spacecraft-design-lab-2019/SolarActuators/Reference Design - Energy Harvester Board/EBH-10.png

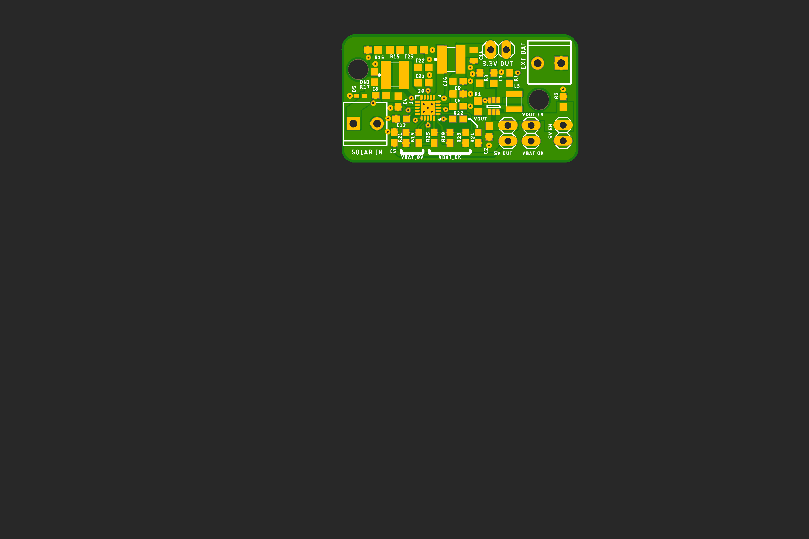
Reference Design - Energy Harvester Board/EBH-10.png
