spacecraft-design-lab-2019/SolarActuators/Reference Design - Energy Harvester Board/OSH EHB-10 2018-04-07/EBH-10.png

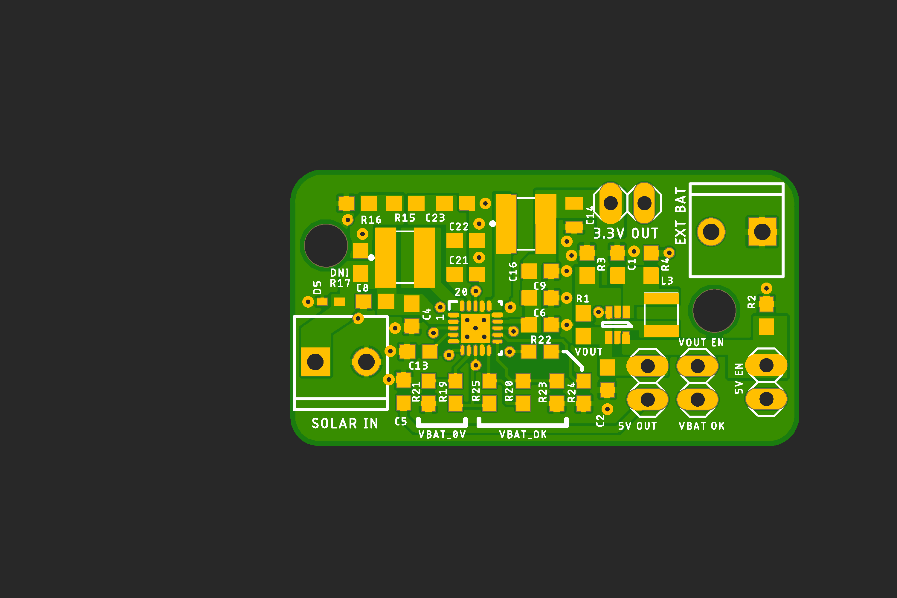
Reference Design - Energy Harvester Board/OSH EHB-10 2018-04-07/EBH-10.png
