spacecraft-design-lab-2019/SolarActuators/Reference Design - Energy Harvester Board/EHB-10_CART_2018-04-10 .xls

CART:4/10/2018 9:01:02 PM
Mouser # | Mfr. # | Manufacturer | Customer # | Description | RoHS | Lifecycle | Order Qty. | Price (USD) | Ext.: (USD)
71-CRCW06037M32FKEA | CRCW06037M32FKEA | Vishay |  | Thick Film Resistors - SMD 1/10watt 7.32Mohms 0.01 | RoHS Compliant By Exemption |  | 100 | $0.026 | $2.60
71-CRCW06038M25FKEA | CRCW06038M25FKEA | Vishay |  | Thick Film Resistors - SMD 1/10watt 8.25Mohms 0.01 | RoHS Compliant By Exemption |  | 100 | $0.026 | $2.60
71-CRCW06035M62FKEA | CRCW06035M62FKEA | Vishay |  | Thick Film Resistors - SMD 1/10watt 5.62Mohms 0.01 | RoHS Compliant By Exemption |  | 100 | $0.026 | $2.60
71-CRCW06034M53FKEA | CRCW06034M53FKEA | Vishay |  | Thick Film Resistors - SMD 1/10watt 4.53Mohms 0.01 | RoHS Compliant By Exemption |  | 100 | $0.026 | $2.60
71-CRCW0603-4.75M-E3 | CRCW06034M75FKEA | Vishay |  | Thick Film Resistors - SMD 1/10watt 4.75Mohms 1% | RoHS Compliant By Exemption |  | 100 | $0.017 | $1.70
652-CR0603FX-3743ELF | CR0603-FX-3743ELF | Bourns |  | Thick Film Resistors - SMD 374K ohm 1% | RoHS Compliant By Exemption |  | 100 | $0.015 | $1.50
71-CRCW0603-110K-E3 | CRCW0603110KFKEA | Vishay |  | Thick Film Resistors - SMD 1/10watt 110Kohms 1% | RoHS Compliant By Exemption |  | 100 | $0.017 | $1.70
71-RCG06031M00FKEA | RCG06031M00FKEA | Vishay |  | Thick Film Resistors - SMD .1watt 1Mohms 1% 0603 100ppm | RoHS Compliant |  | 100 | $0.018 | $1.80
71-CRCW06030000Z0EAC | CRCW06030000Z0EAC | Vishay |  | Thick Film Resistors - SMD 1/10Watt 0ohms Commercial Use | RoHS Compliant By Exemption | New Product | 500 | $0.018 | $9.00
571-4-146278-0 | 4-146278-0 | TE Connectivity |  | Headers & Wire Housings 40 MODII HDR SRST B/A .100CL | No |  | 5 | $1.78 | $8.90
723-BCAP0325P270S17 | BCAP0325 P270 S17 | Maxwell Technologies |  | Supercapacitors / Ultracapacitors 2.7V, 325F, snap-in | RoHS Compliant | New Product | 1 | $15.93 | $15.93
581-SCCV60B107MRB | SCCV60B107MRB | AVX |  | Supercapacitors / Ultracapacitors 2.7V 100F ESR15mOhms 18x60mm Radial Leads | RoHS Compliant | New Product | 3 | $8.08 | $24.24
994-LPS4018-103MRC | LPS4018-103MRC | Coilcraft |  | Fixed Inductors LPS4018 Low Profile 10uH 1.25A 20% SMD | RoHS Compliant |  | 10 | $1.00 | $10.00
994-LPS4018-223MRC | LPS4018-223MRC | Coilcraft |  | Fixed Inductors LPS4018 Low Profile 22uH 0.9A 20% SMD | RoHS Compliant |  | 10 | $1.00 | $10.00
994-EPL3015-472MLB | EPL3015-472MLB | Coilcraft |  | Fixed Inductors EPL3015 AEC-Q200 4.7 uH 20 % 1.4 A | RoHS Compliant |  | 10 | $1.16 | $11.60
621-BZT52C4V7T-7 | BZT52C4V7T-7 | Diodes Incorporated |  | Zener Diodes 300mW 4.7V Zener AEC-Q101 Qualified | RoHS Compliant |  | 10 | $0.181 | $1.81
534-3030 | 3030 | Keystone Electronics |  | Coin Cell Battery Holders 10MM SM COIN CELL CLIP | RoHS Compliant |  | 5 | $0.52 | $2.60
