spacecraft-design-lab-2019/SolarActuators/EnergyHarvesterBoardTest/Vin_smaller than_Vout(EXT BAT)_2019-12-09-15-39-02.857.pdf

Min | Max | Average | Marker X1 | Marker X2
0.009 V | 3.177 V | 3.164V | 3.171 V | 3.177 V
12/9/2019 15:33:30.942 | 12/9/2019 15:30:48.727 | - 12/9/2019 | 15:18:19.925 | 12/9/2019 15:33:16.929
Upper Limit | Lower Limit

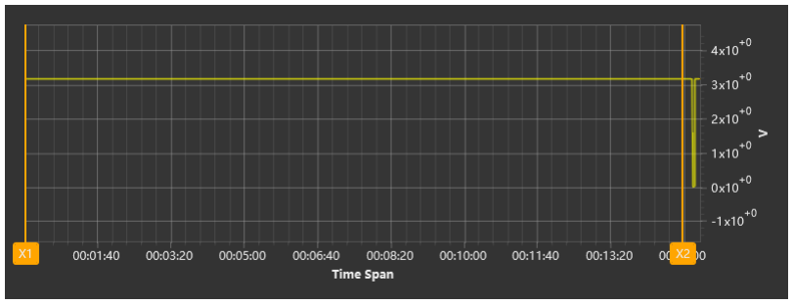
[picture p5: figure]

Trend Chart

Record | Time | Function | Reading | Unit | Limit Test

Device under test

Meter ID

Start Time

Stop time

Elapsed Time

Interval

Total Readings

U1241C MY59350007

12/9/2019 15:18:17.924

12/9/2019 15:33:39.952

00:00:15:22:028

00:00:01:001

922

Logging Session

Record | Time | Function | Reading | Unit | Limit Test
723 | 12/9/2019 15:30:20.698 | Volt {DC} | 3.176 | V
724 | 12/9/2019 15:30:21.699 | Volt {DC} | 3.176 | V
725 | 12/9/2019 15:30:22.700 | Volt {DC} | 3.176 | V
726 | 12/9/2019 15:30:23.701 | Volt {DC} | 3.176 | V
727 | 12/9/2019 15:30:24.702 | Volt {DC} | 3.176 | V
728 | 12/9/2019 15:30:25.704 | Volt {DC} | 3.176 | V
729 | 12/9/2019 15:30:26.705 | Volt {DC} | 3.176 | V
730 | 12/9/2019 15:30:27.706 | Volt {DC} | 3.176 | V
731 | 12/9/2019 15:30:28.707 | Volt {DC} | 3.176 | V
732 | 12/9/2019 15:30:29.709 | Volt {DC} | 3.176 | V
733 | 12/9/2019 15:30:30.709 | Volt {DC} | 3.176 | V
734 | 12/9/2019 15:30:31.710 | Volt {DC} | 3.176 | V
735 | 12/9/2019 15:30:32.711 | Volt {DC} | 3.176 | V
736 | 12/9/2019 15:30:33.712 | Volt {DC} | 3.176 | V
737 | 12/9/2019 15:30:34.713 | Volt {DC} | 3.176 | V
738 | 12/9/2019 15:30:35.715 | Volt {DC} | 3.176 | V
739 | 12/9/2019 15:30:36.716 | Volt {DC} | 3.176 | V
740 | 12/9/2019 15:30:37.717 | Volt {DC} | 3.176 | V

Record | Time | Function | Reading | Unit | Limit Test
741 | 12/9/2019 15:30:38.718 | Volt {DC} | 3.176 | V
742 | 12/9/2019 15:30:39.720 | Volt {DC} | 3.176 | V
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
919 | 12/9/2019 15:33:36.948 | Volt {DC} | 3.177 | V
920 | 12/9/2019 15:33:37.949 | Volt {DC} | 3.177 | V

Remark

Record | Time | Function | Reading | Unit | Limit Test
921 | 12/9/2019 15:33:38.951 | Volt {DC} | 3.177 | V
922 | 12/9/2019 15:33:39.952 | Volt {DC} | 3.177 | V
