spacecraft-design-lab-2019/SolarActuators/EnergyHarvesterBoardTest/Charging Voltage plot_2019-12-09-11-46-00.449.pdf

Min | Max | Average | Marker X1 | Marker X2
3.668 V | 3.979 V | 3.700V
12/9/2019 11:33:59.491 | 12/9/2019 11:33:54.485 | -

Trend Chart

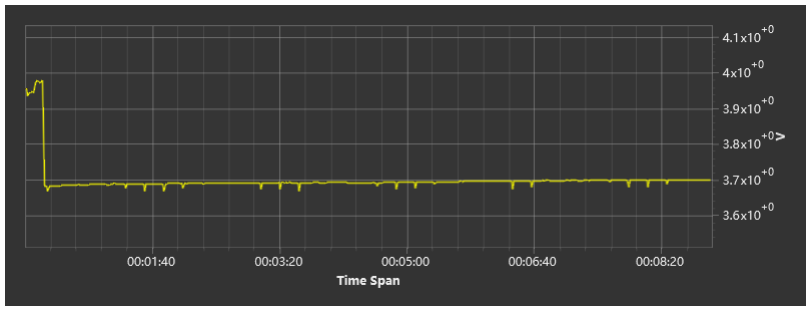
[picture p6: figure]

Record | Time | Function | Reading | Unit
340 | 12/9/2019 11:39:20.881 | Volt {DC} | 3.695 | V
341 | 12/9/2019 11:39:21.882 | Volt {DC} | 3.695 | V
342 | 12/9/2019 11:39:22.883 | Volt {DC} | 3.696 | V

Device under test

Meter ID

Start Time

Stop time

Elapsed Time

Interval

Total Readings

U1241C MY59350007

12/9/2019 11:33:41.469

12/9/2019 11:42:40.097

00:00:08:58:628

00:00:01:001

539

Logging Session

Record | Time | Function | Reading | Unit
343 | 12/9/2019 11:39:23.884 | Volt {DC} | 3.696 | V
344 | 12/9/2019 11:39:24.885 | Volt {DC} | 3.695 | V
345 | 12/9/2019 11:39:25.888 | Volt {DC} | 3.696 | V
346 | 12/9/2019 11:39:26.888 | Volt {DC} | 3.697 | V
347 | 12/9/2019 11:39:27.889 | Volt {DC} | 3.696 | V
348 | 12/9/2019 11:39:28.891 | Volt {DC} | 3.696 | V
349 | 12/9/2019 11:39:29.892 | Volt {DC} | 3.696 | V
350 | 12/9/2019 11:39:30.893 | Volt {DC} | 3.696 | V
351 | 12/9/2019 11:39:31.894 | Volt {DC} | 3.696 | V
352 | 12/9/2019 11:39:32.895 | Volt {DC} | 3.696 | V
353 | 12/9/2019 11:39:33.896 | Volt {DC} | 3.696 | V
354 | 12/9/2019 11:39:34.897 | Volt {DC} | 3.696 | V
355 | 12/9/2019 11:39:35.898 | Volt {DC} | 3.697 | V
356 | 12/9/2019 11:39:36.899 | Volt {DC} | 3.697 | V
357 | 12/9/2019 11:39:37.900 | Volt {DC} | 3.697 | V
358 | 12/9/2019 11:39:38.900 | Volt {DC} | 3.697 | V
359 | 12/9/2019 11:39:39.901 | Volt {DC} | 3.697 | V
360 | 12/9/2019 11:39:40.903 | Volt {DC} | 3.697 | V

Record | Time | Function | Reading | Unit
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
535 | 12/9/2019 11:42:36.094 | Volt {DC} | 3.700 | V
536 | 12/9/2019 11:42:37.095 | Volt {DC} | 3.700 | V
537 | 12/9/2019 11:42:38.096 | Volt {DC} | 3.700 | V
538 | 12/9/2019 11:42:39.097 | Volt {DC} | 3.700 | V
539 | 12/9/2019 11:42:40.097 | Volt {DC} | 3.700 | V

Remark
