spacecraft-design-lab-2019/SolarActuators/EnergyHarvesterBoardTest/Charging Voltage plot.PNG

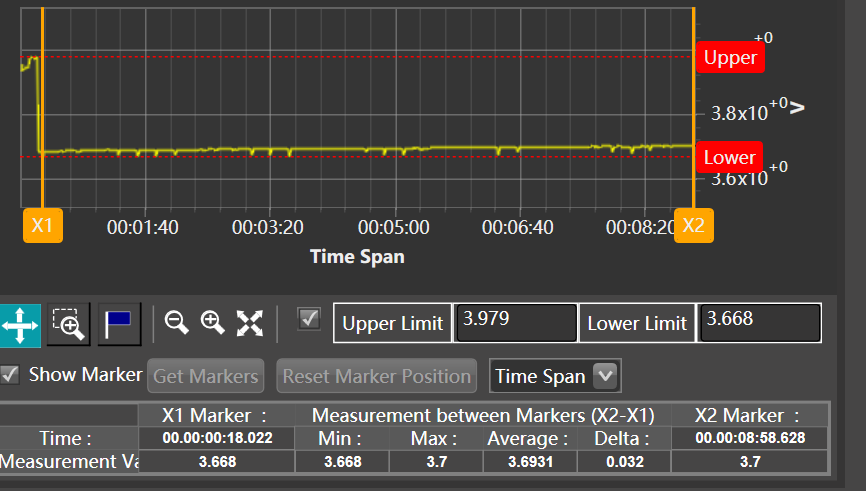
EnergyHarvesterBoardTest/Charging Voltage plot.PNG
