spacecraft-design-lab-2019/SolarActuators/(threads)

Thread 5 (2019-10-16):

Evaluate energy harvesting board (BQ25570RGRR)

maholli, 2019-10-16:

maholli, 2019-10-17:
Same as https://github.com/spacecraft-design-lab-2019/documentation/issues/68

Closed 2019-10-17.
