spacecraft-design-lab-2019/SolarActuators/EnergyHarvesterBoardTest/Energy harvesting board testing 1112.pdf

# Energy harvesting board testing 1112

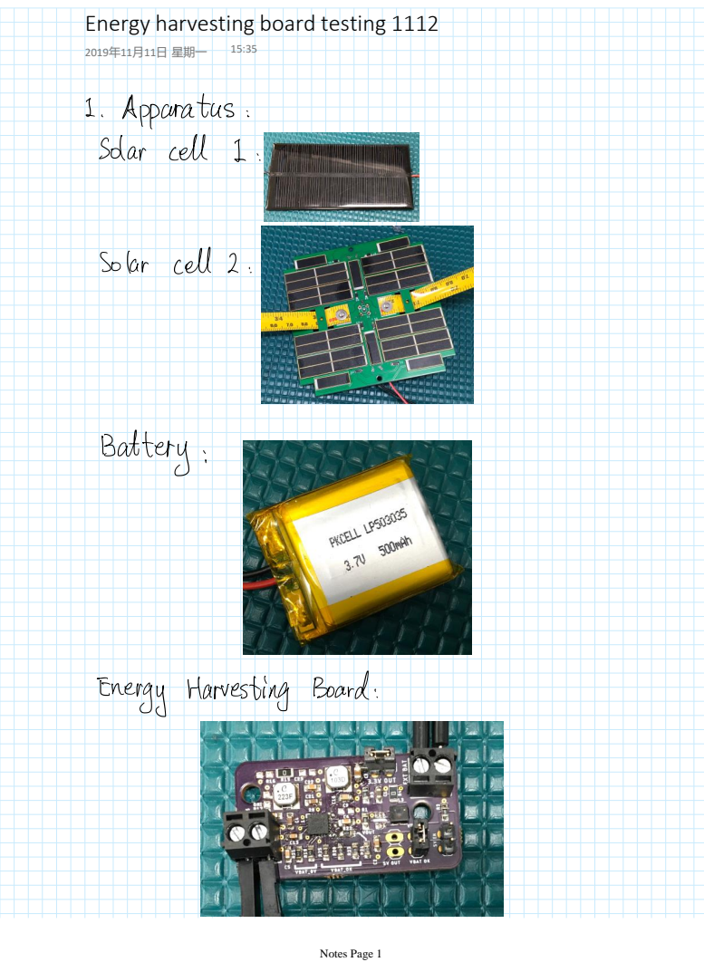
[picture p8: page 1]
星期一; Notes Page 1

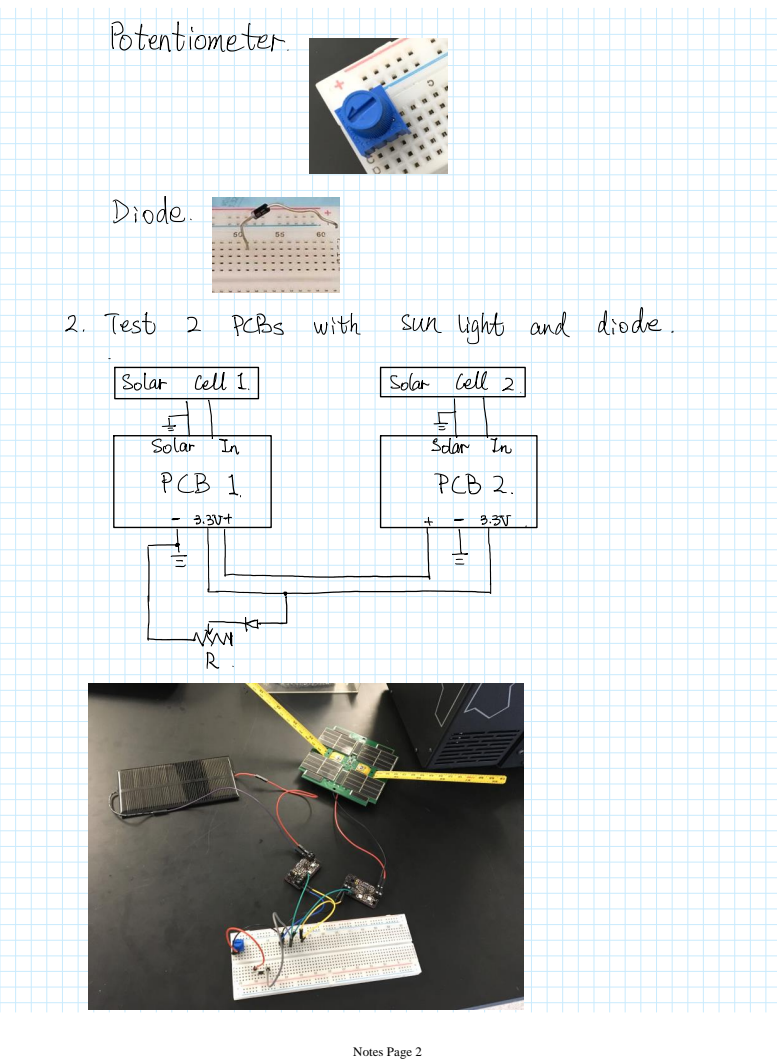
[picture p9: page 2]

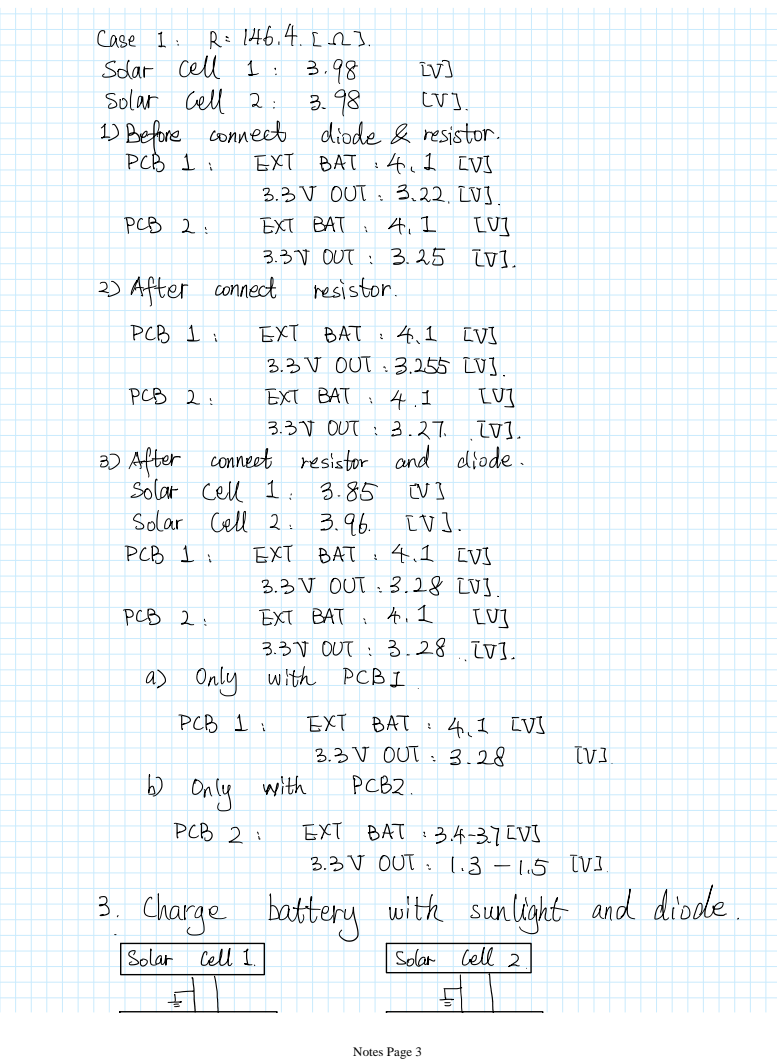
[picture p10: page 3]

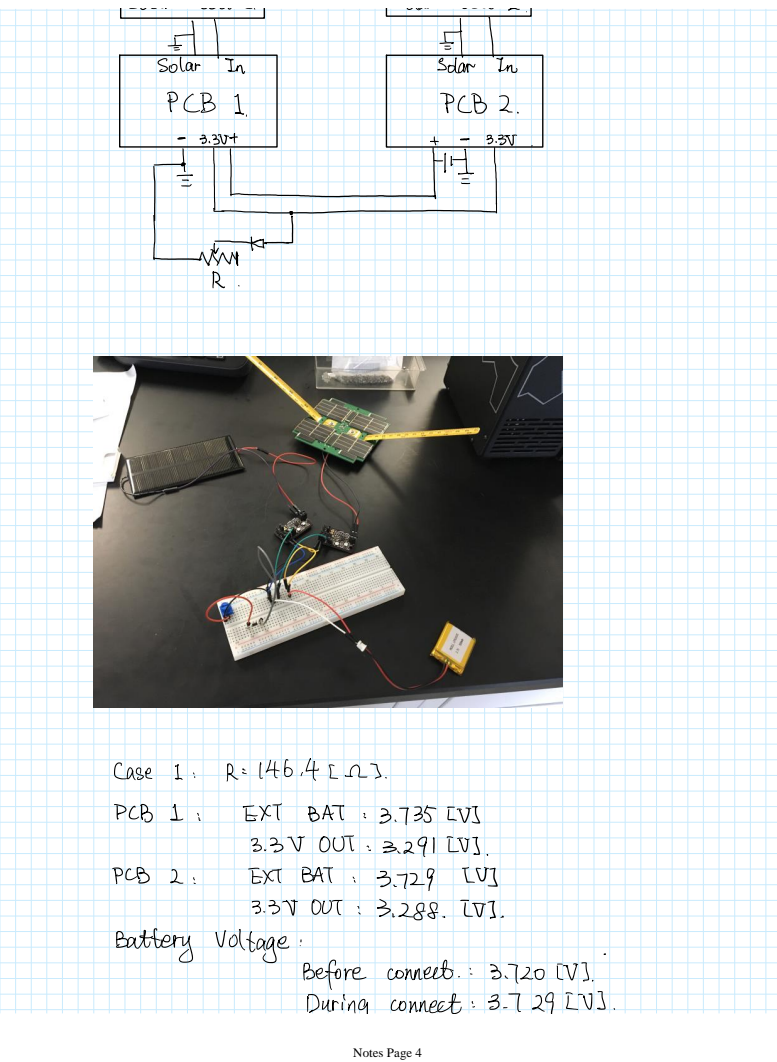
[picture p11: page 4]

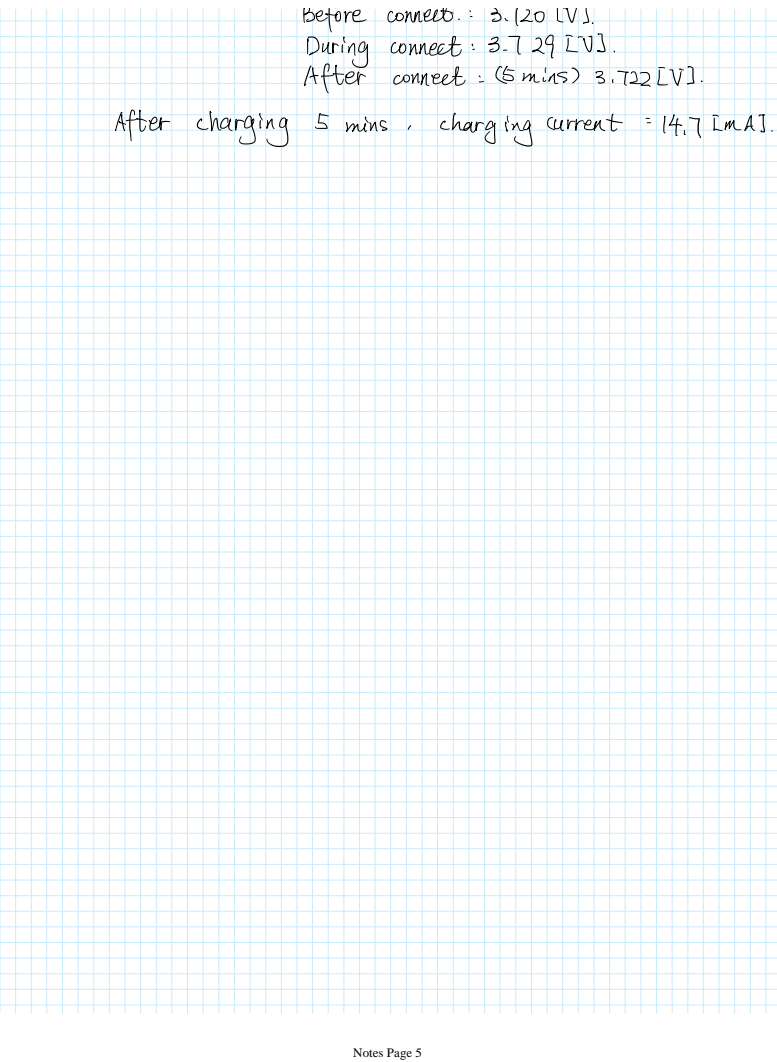
[picture p12: page 5]
