spacecraft-design-lab-2019/SolarActuators/EnergyHarvesterBoardTest/Energy_harvesting_board_testing_1111.pdf

# Energy harvesting board testing 1111

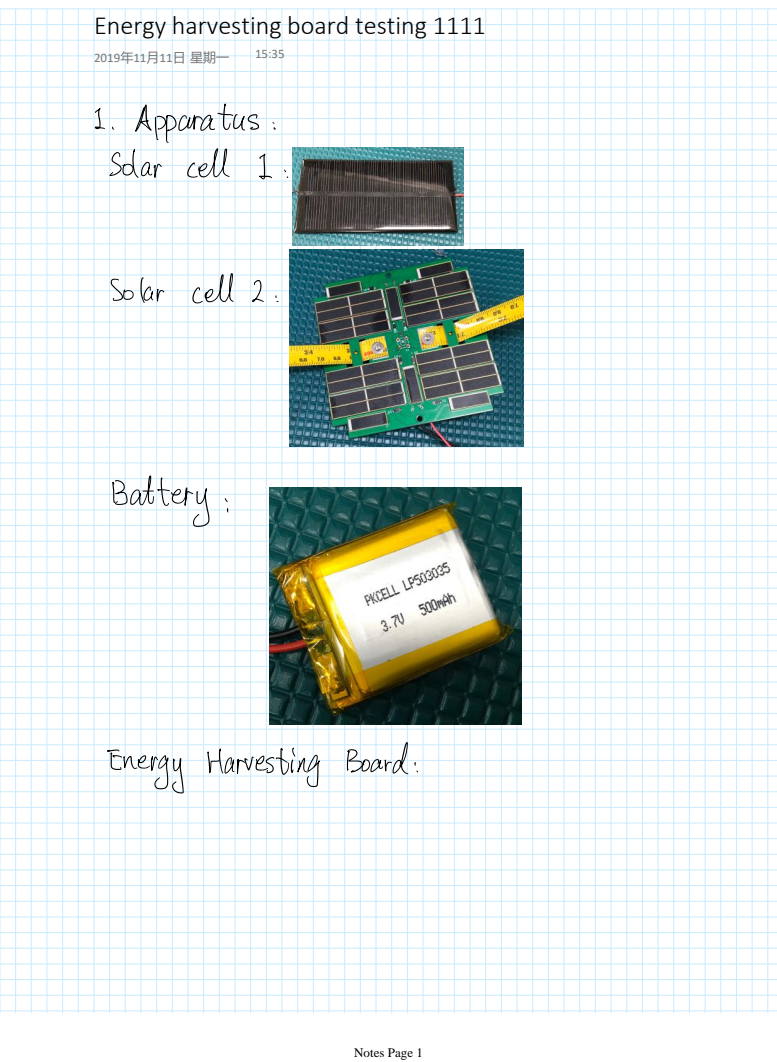
[picture p13: page 1]
星期一; Notes Page 1

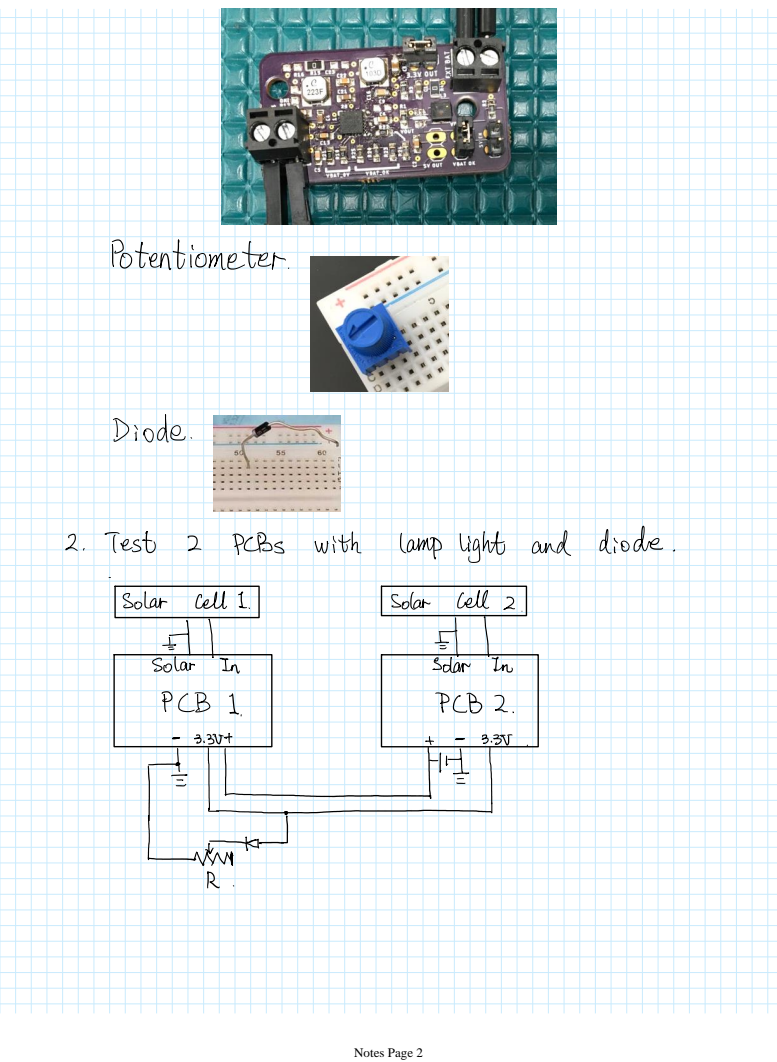
[picture p14: page 2]

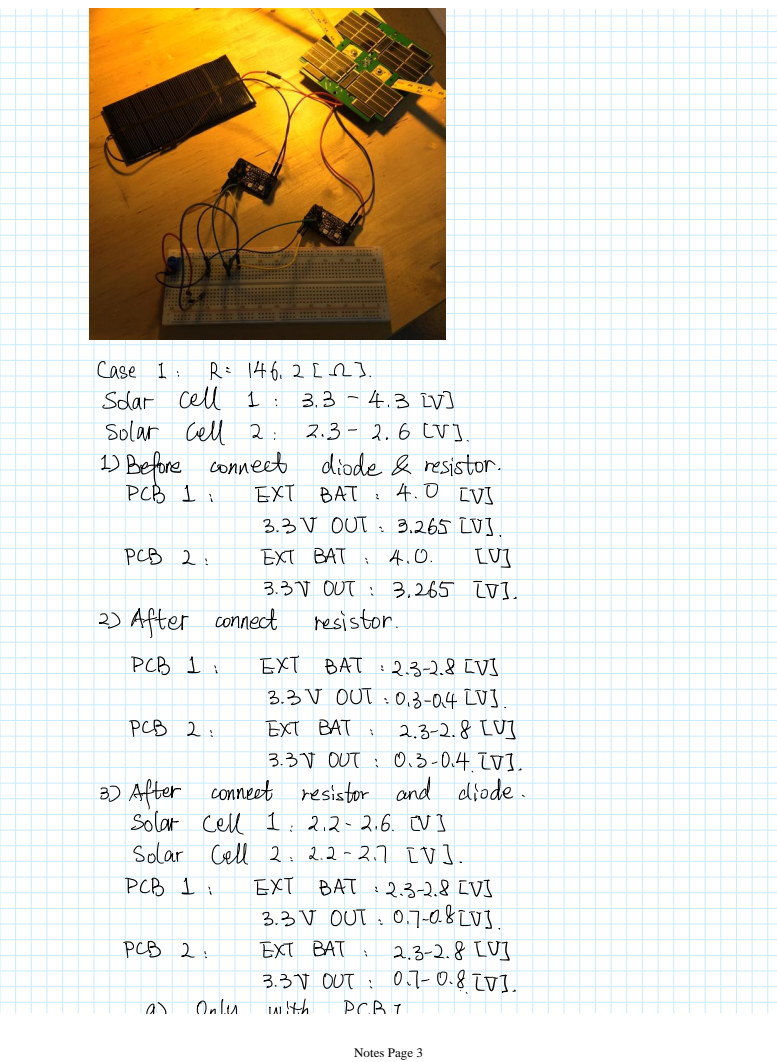
[picture p15: page 3]

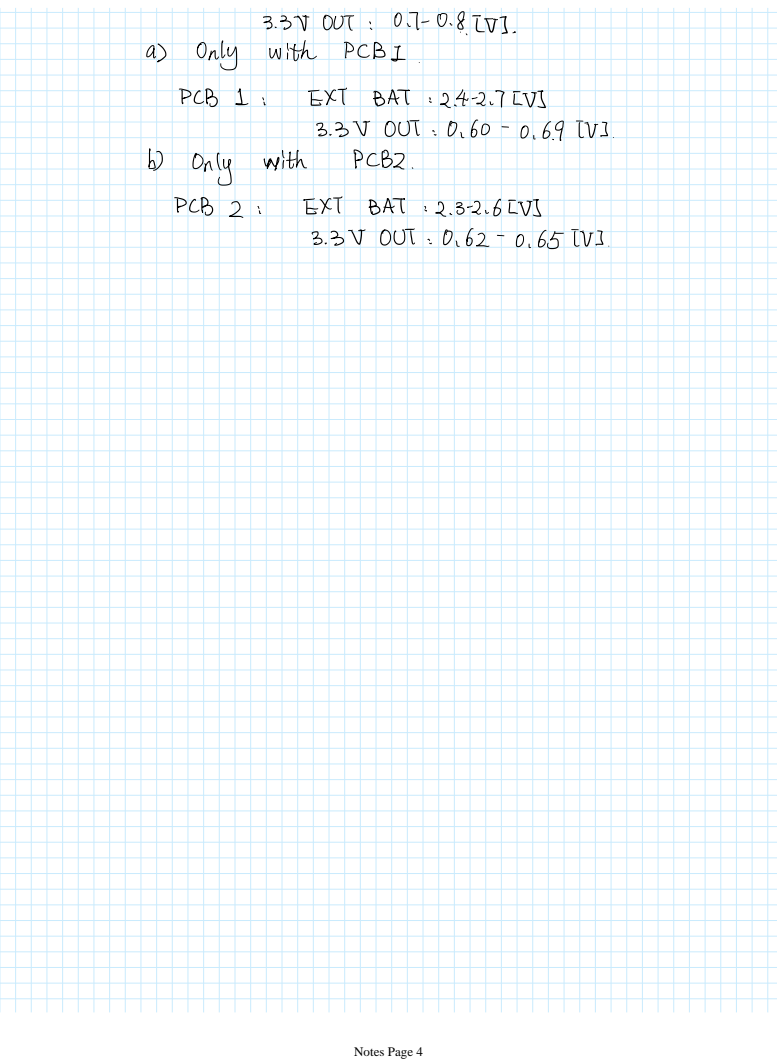
[picture p16: page 4]
