spacecraft-design-lab-2019/SolarActuators/EnergyHarvesterBoardTest/Energy harvesting board testing 1105.pdf

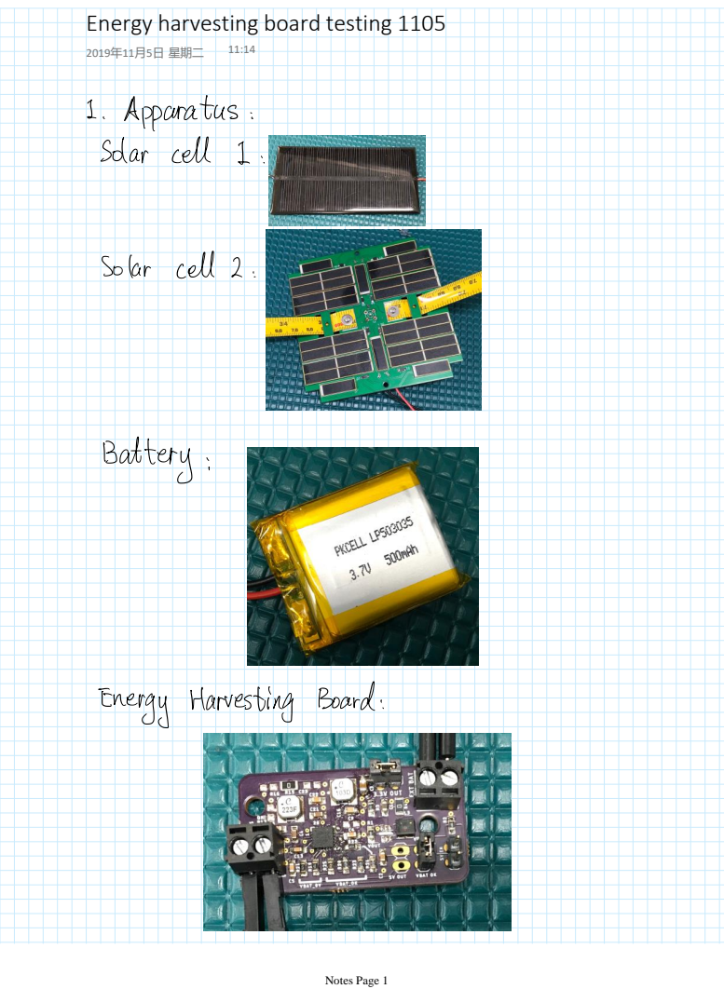
[picture p17: page 1]
2019年11月5日 星期二; Notes Page 1

Energy harvesting board testing 1105

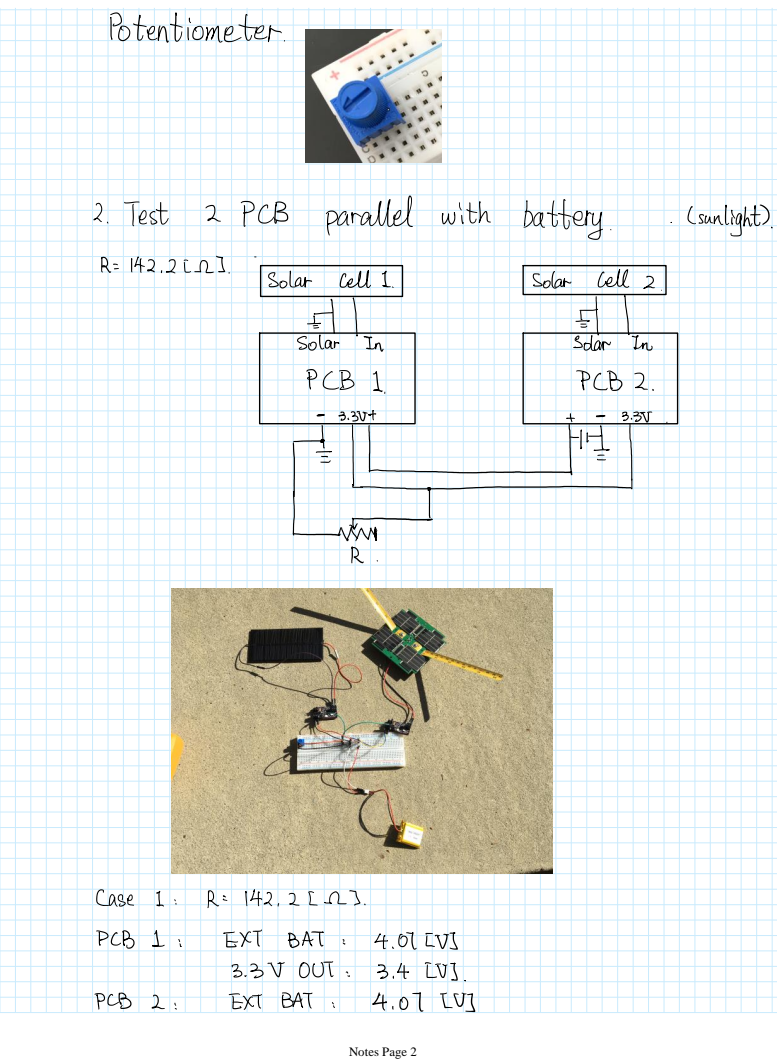
[picture p18: page 2]

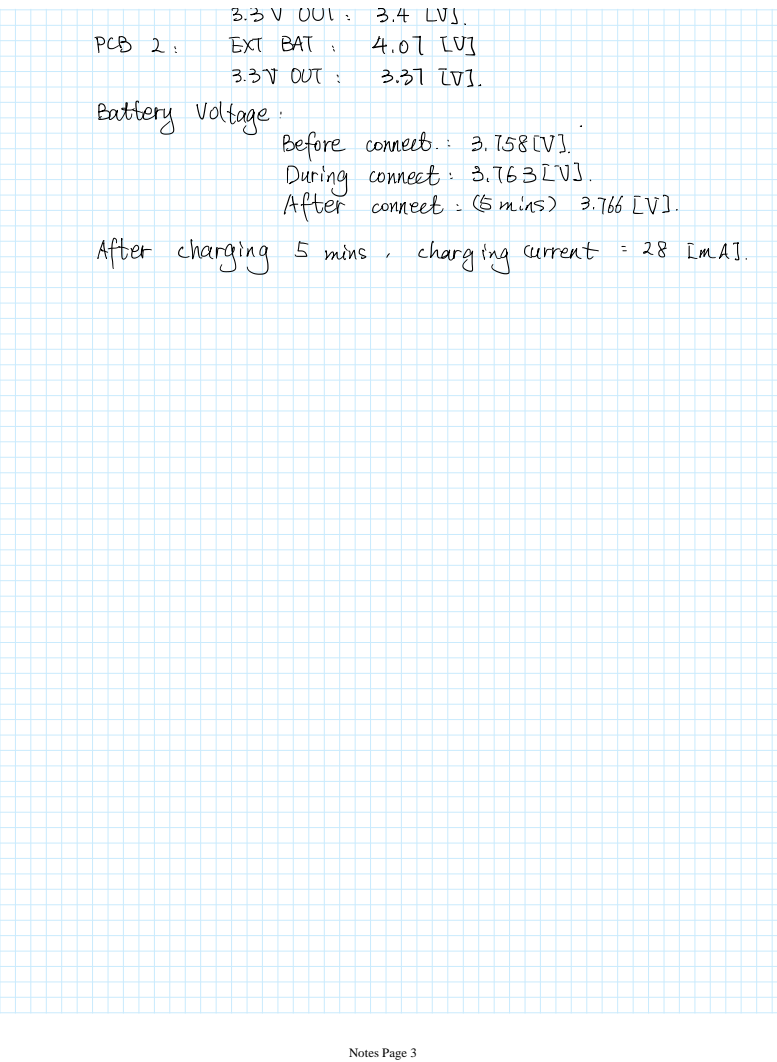
[picture p19: page 3]
