spacecraft-design-lab-2019/SolarActuators/EnergyHarvesterBoardTest/Energy_harvesting_board_testing_1029.pdf

# Energy harvesting board testing 1029

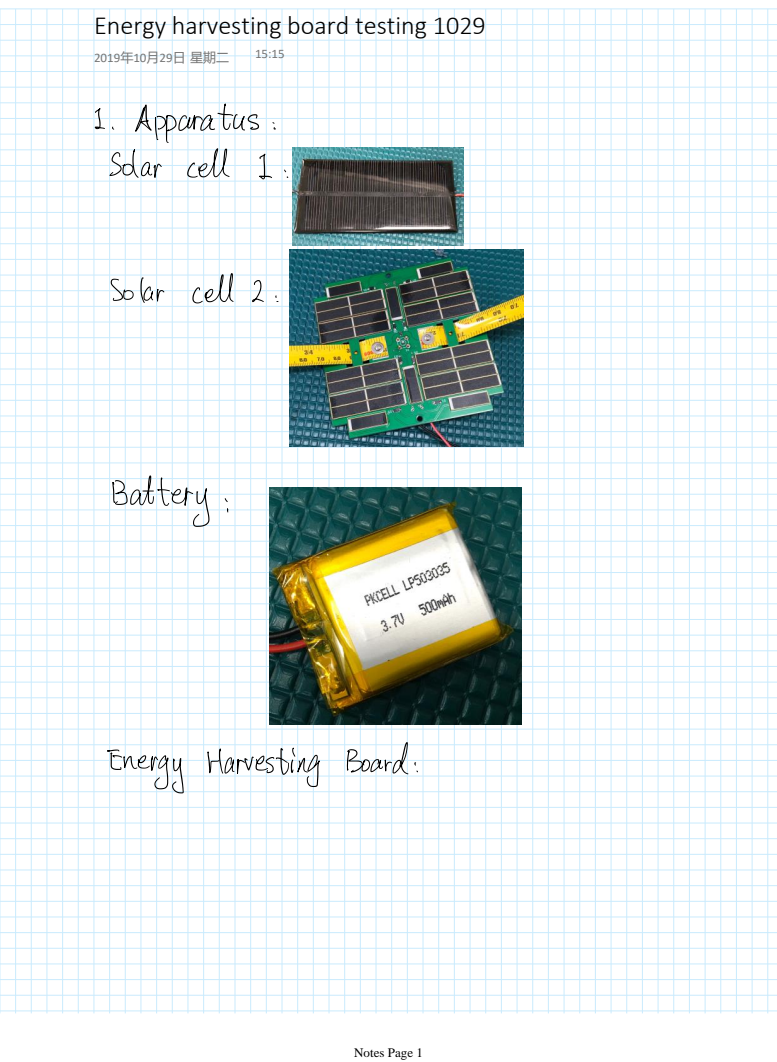
[picture p20: page 1]
星期二; Notes Page 1

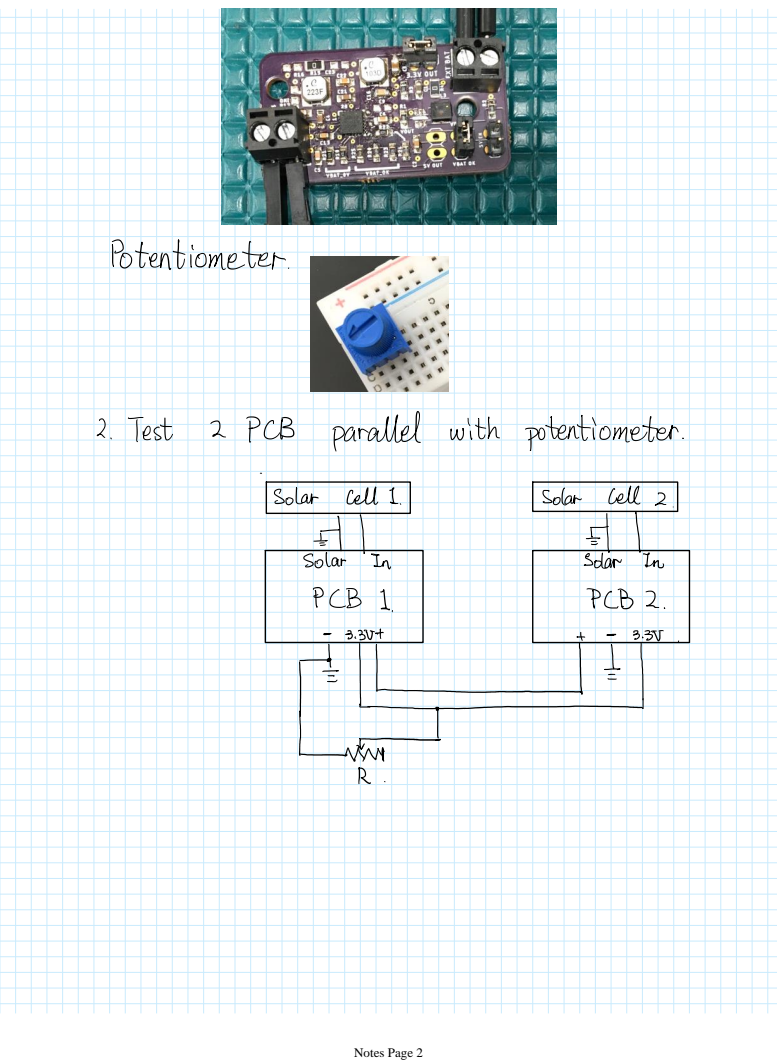
[picture p21: page 2]

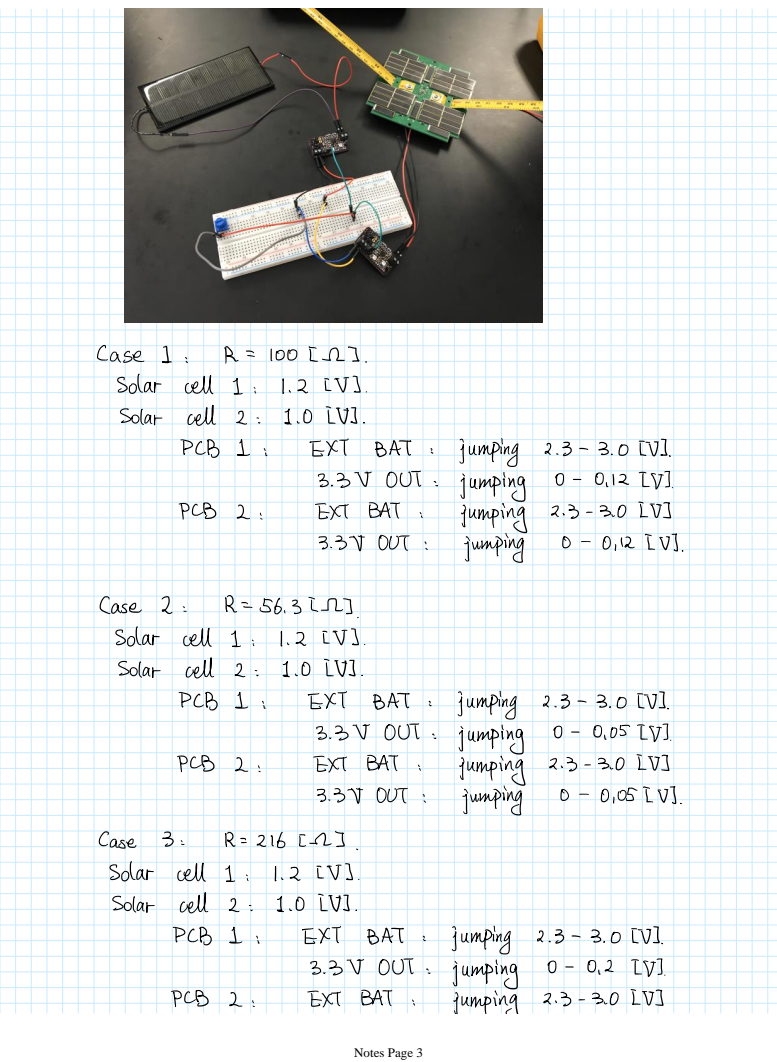
[picture p22: page 3]

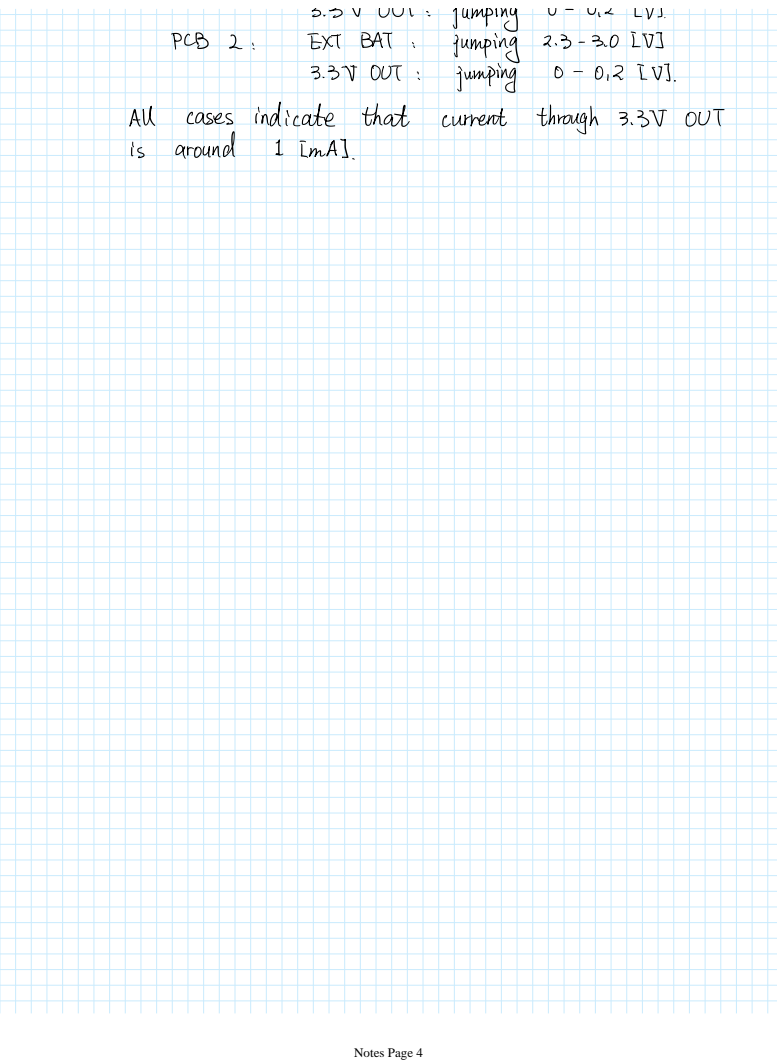
[picture p23: page 4]
