spacecraft-design-lab-2019/SolarActuators/EnergyHarvesterBoardTest/Energy_harvesting_board_testing_1030.pdf

# Energy harvesting board testing 1030

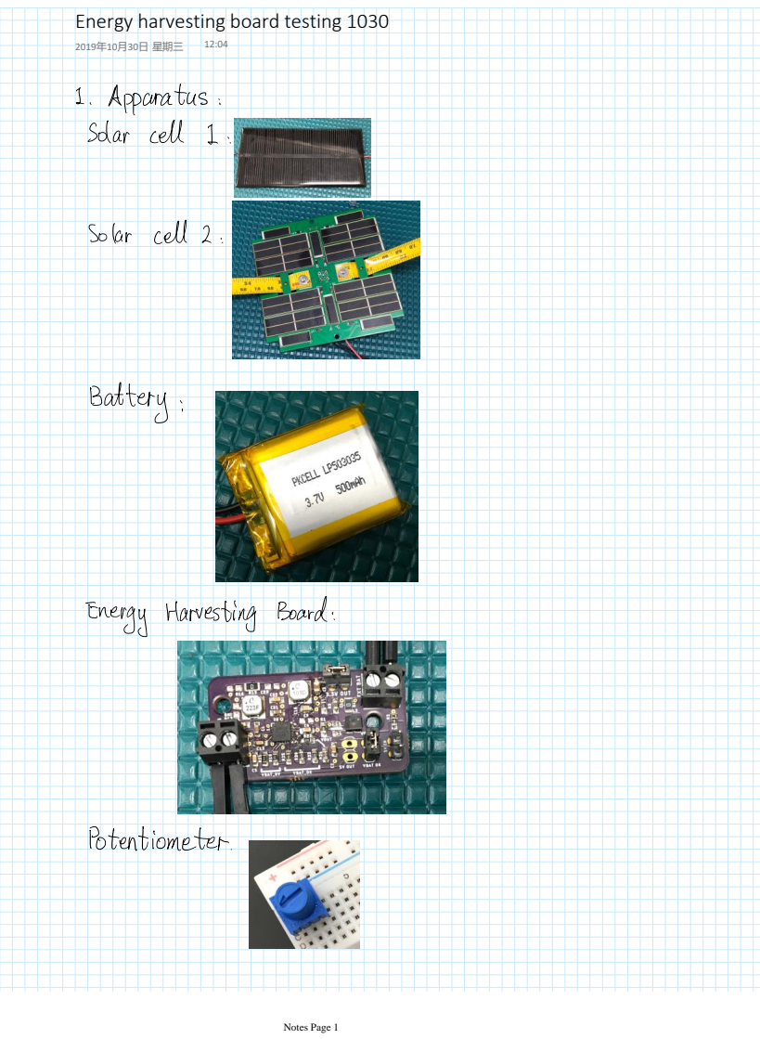
[picture p24: page 1]
星期三; Notes Page 1

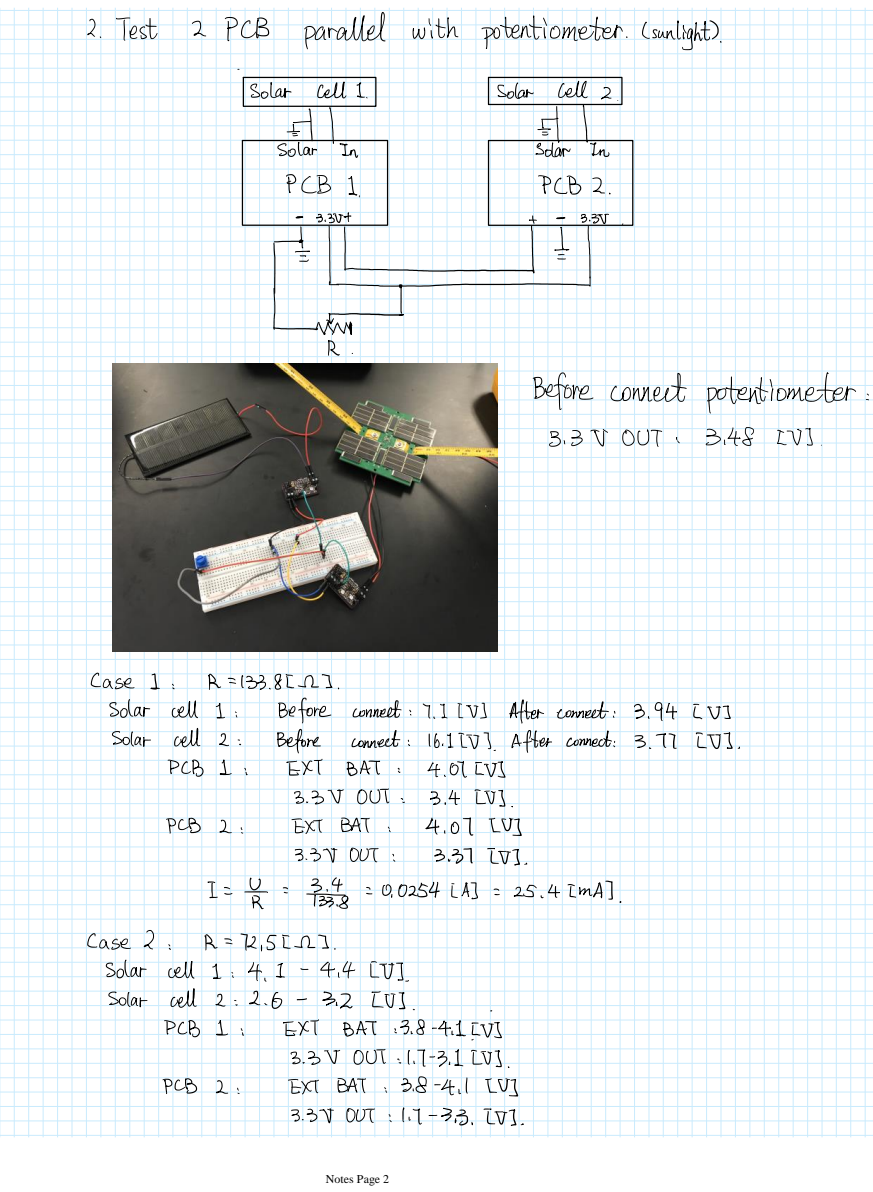
[picture p25: page 2]

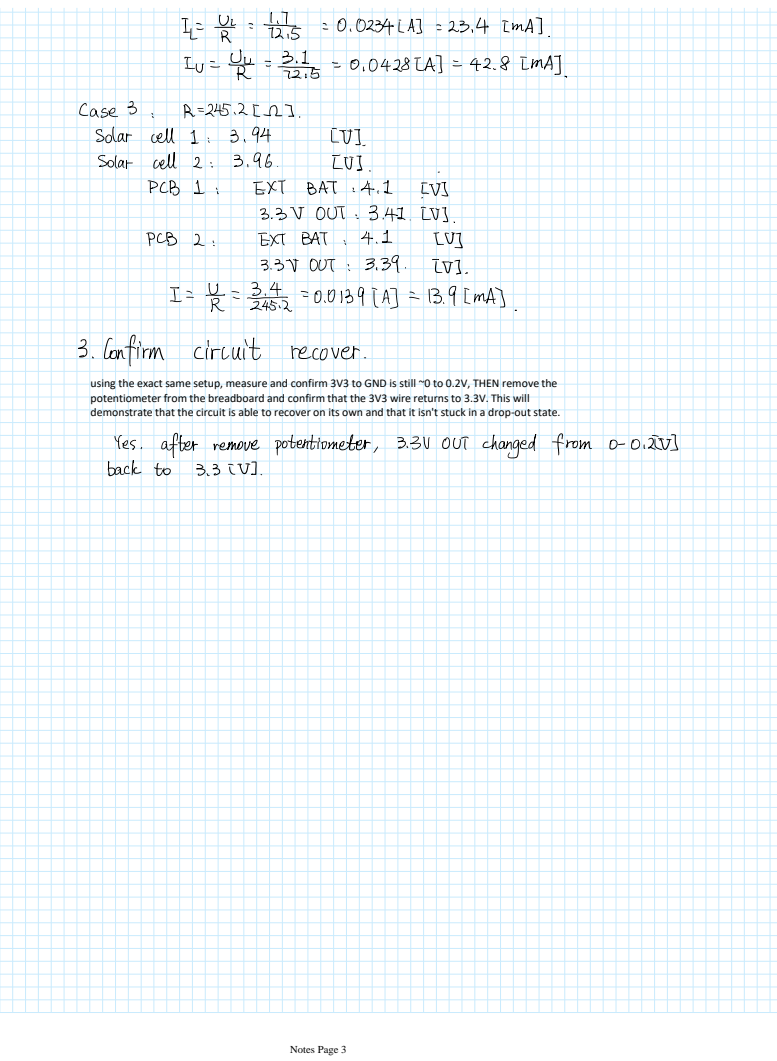
[picture p26: page 3]

using the exact same setup, measure and confirm 3V3 to GND is still ~0 to 0.2V, THEN remove the
potentiometer from the breadboard and confirm that the 3V3 wire returns to 3.3V. This will
demonstrate that the circuit is able to recover on its own and that it isn't stuck in a drop-out state.
