spacecraft-design-lab-2019/SolarActuators/EnergyHarvesterBoardTest/Energy_harvesting_board_testing_1026.pdf

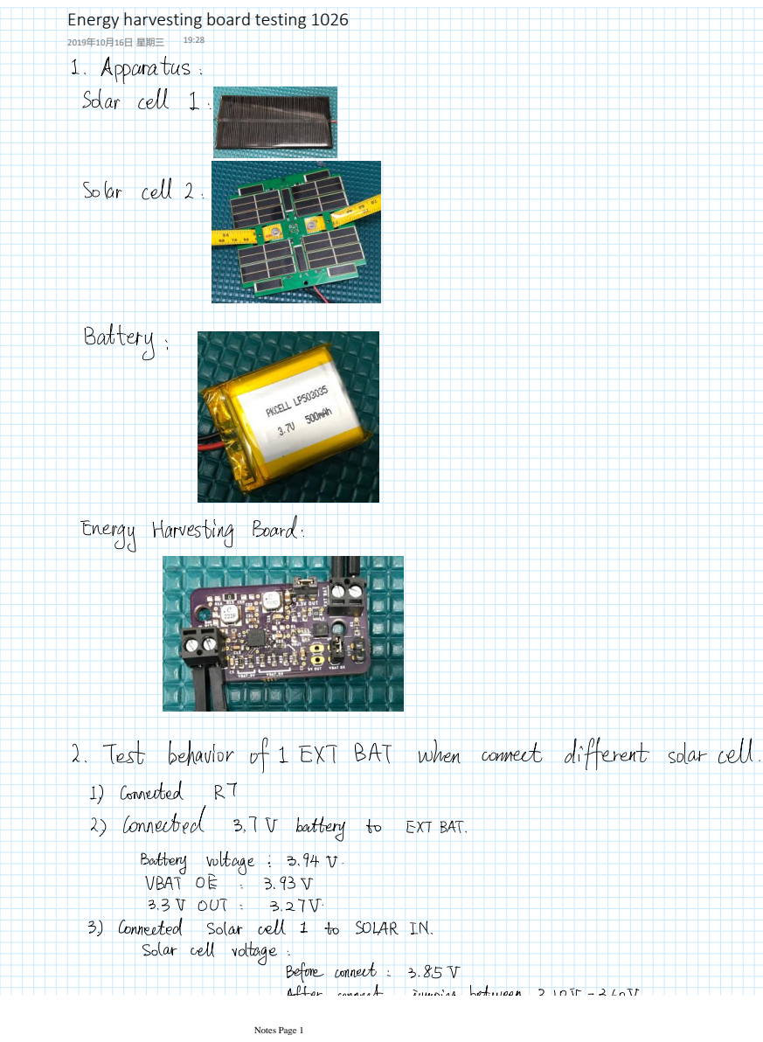
[picture p27: page 1]
星期三; Notes Page 1

Energy harvesting board testing 1026

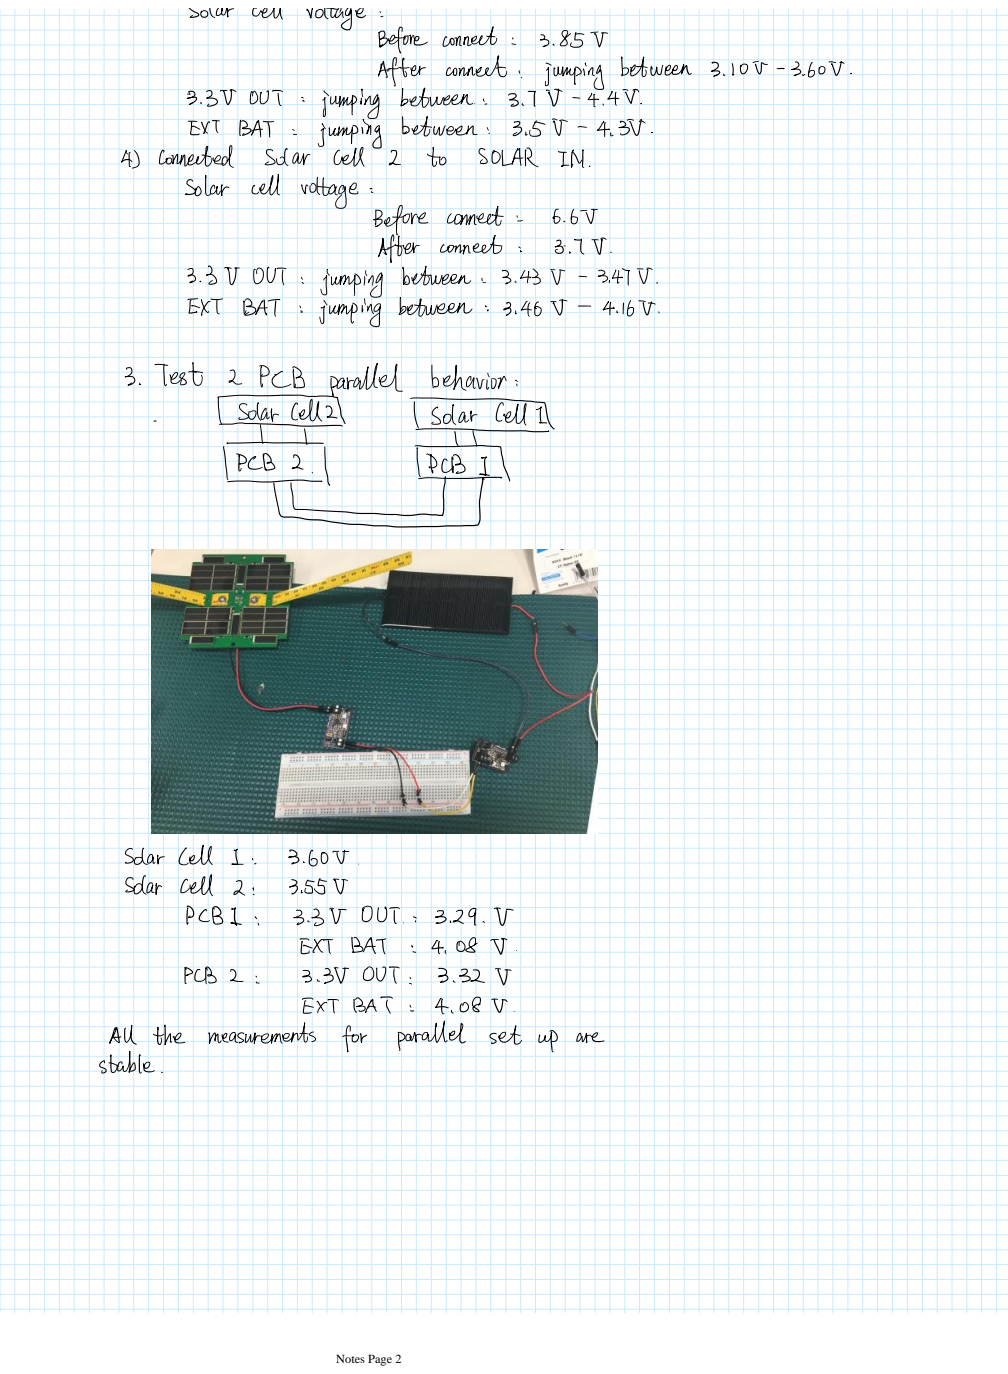
[picture p28: page 2]
Notes Page 2
