spacecraft-design-lab-2019/SolarActuators/SolarZ/SolarZ/SolarZ.kicad_pcb

## KiCad design SolarZ/SolarZ/SolarZ.kicad_pcb (2019-10-21)

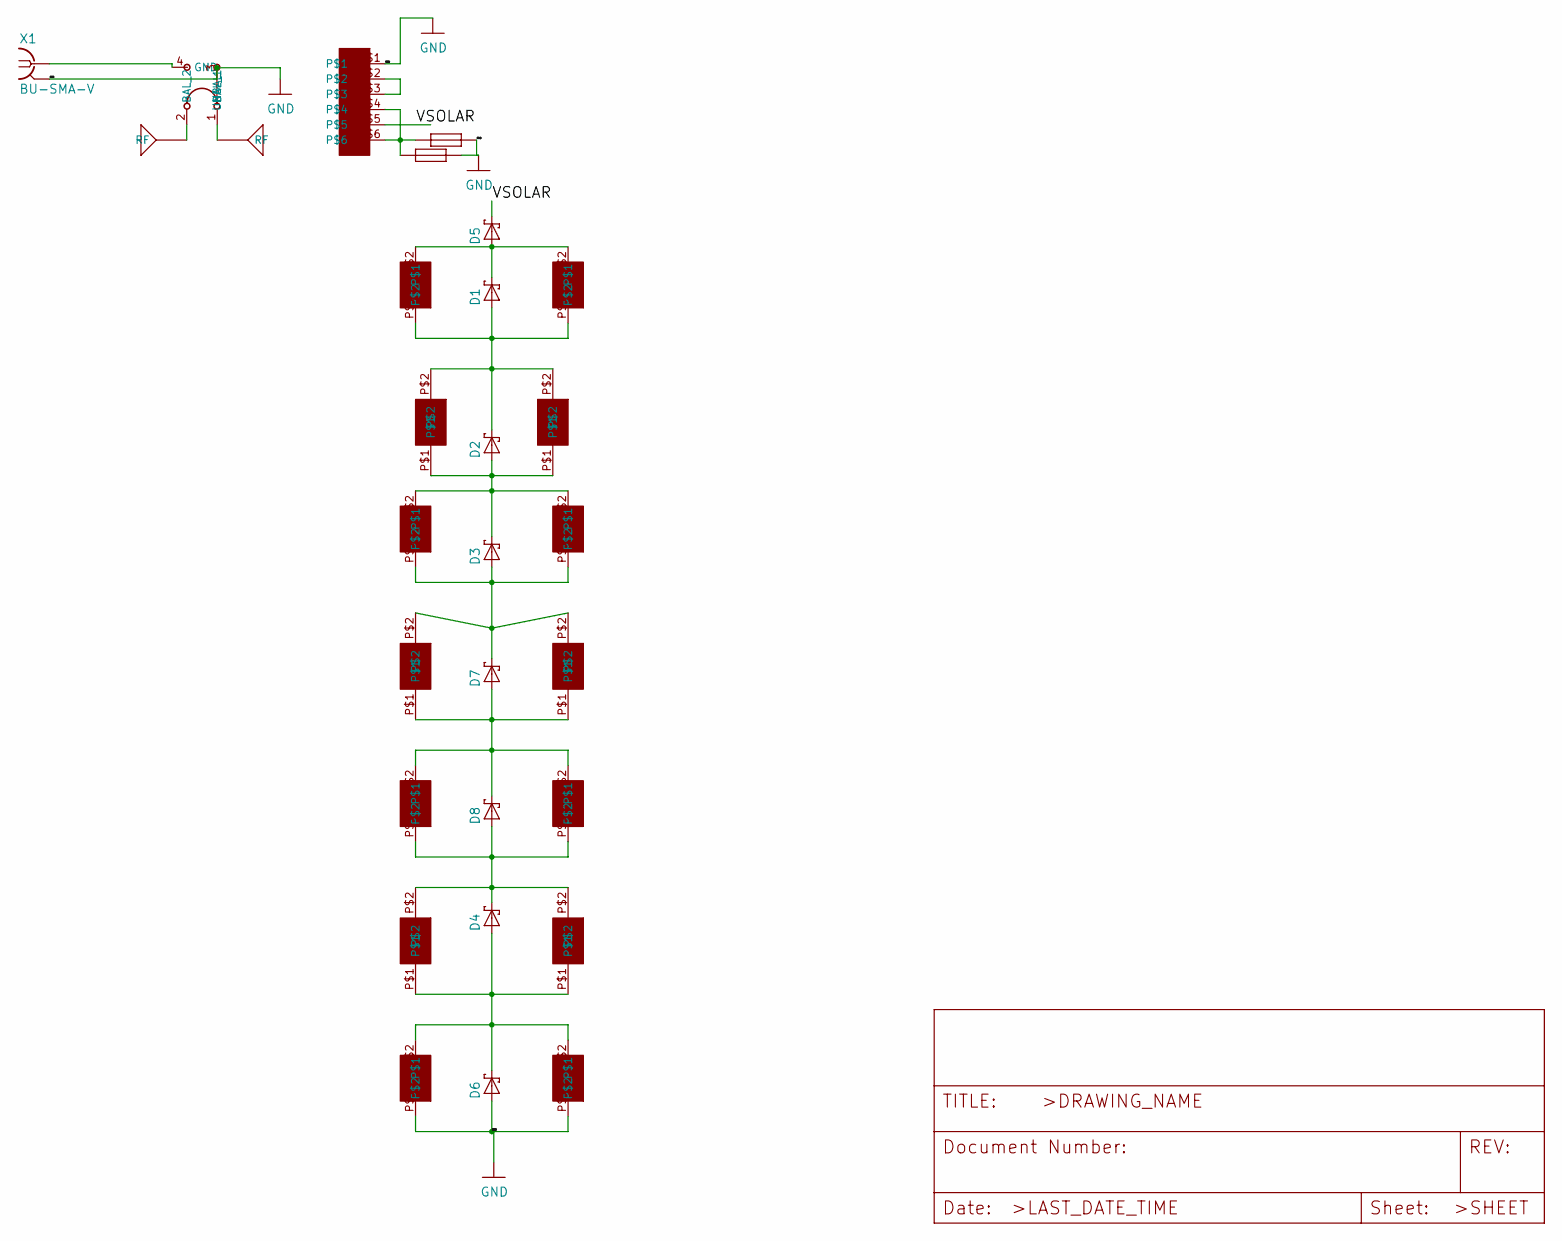
[picture p29: schematic SolarZ.sch]

Parts:
D1, D2, D3, D4, D5, D6, D7, D8: SB_DIODE
F1, F2: BURN_TERM; BURN_WIRE
U$1: BALUN
U$2, U$3: ANTENNA; TAPE
U$4: M20-8760342
UNK1, UNK6, UNK7, UNK10, UNK11, UNK13: KXOB22-04X3F
UNK2, UNK3, UNK4, UNK5, UNK8, UNK9, UNK12, UNK14: SLMD121H04L
X1: BU-SMA-V

Connections:
/VSOLAR: D5.NEG, U$4.P$5
GND: D6.POS, F1.2, F1.20 (2), F1.200 (2), F2.2, F2.20 (2), F2.200 (2), U$1.3 (UNBAL), U$4.P$1, UNK8.P$1, UNK9.P$1, X1.2, X1.3 (2), X1.4 (2), X1.5 (2)
unnamed: D1.NEG, D5.POS, UNK2.P$2, UNK3.P$2
unnamed: D1.POS, D2.NEG, UNK1.P$2, UNK2.P$1, UNK3.P$1, UNK13.P$2
unnamed: D2.POS, D3.NEG, UNK1.P$1, UNK4.P$2, UNK5.P$2, UNK13.P$1
unnamed: D3.POS, D7.NEG, UNK4.P$1, UNK5.P$1, UNK10.P$2, UNK11.P$2
unnamed: D4.NEG, D8.POS, UNK6.P$2, UNK7.P$2, UNK12.P$1, UNK14.P$1
unnamed: D4.POS, D6.NEG, UNK6.P$1, UNK7.P$1, UNK8.P$2, UNK9.P$2
unnamed: D7.POS, D8.NEG, UNK10.P$1, UNK11.P$1, UNK12.P$2, UNK14.P$2
unnamed: F1.1, F1.10 (1), F1.100 (1), F2.1, F2.10 (1), F2.100 (1), U$4.P$4, U$4.P$6
unnamed: U$1.1 (BAL_1), U$2.RF, U$2.RF_2
unnamed: U$1.2 (BAL_2), U$3.RF, U$3.RF_2
unnamed: U$4.P$2, U$4.P$3

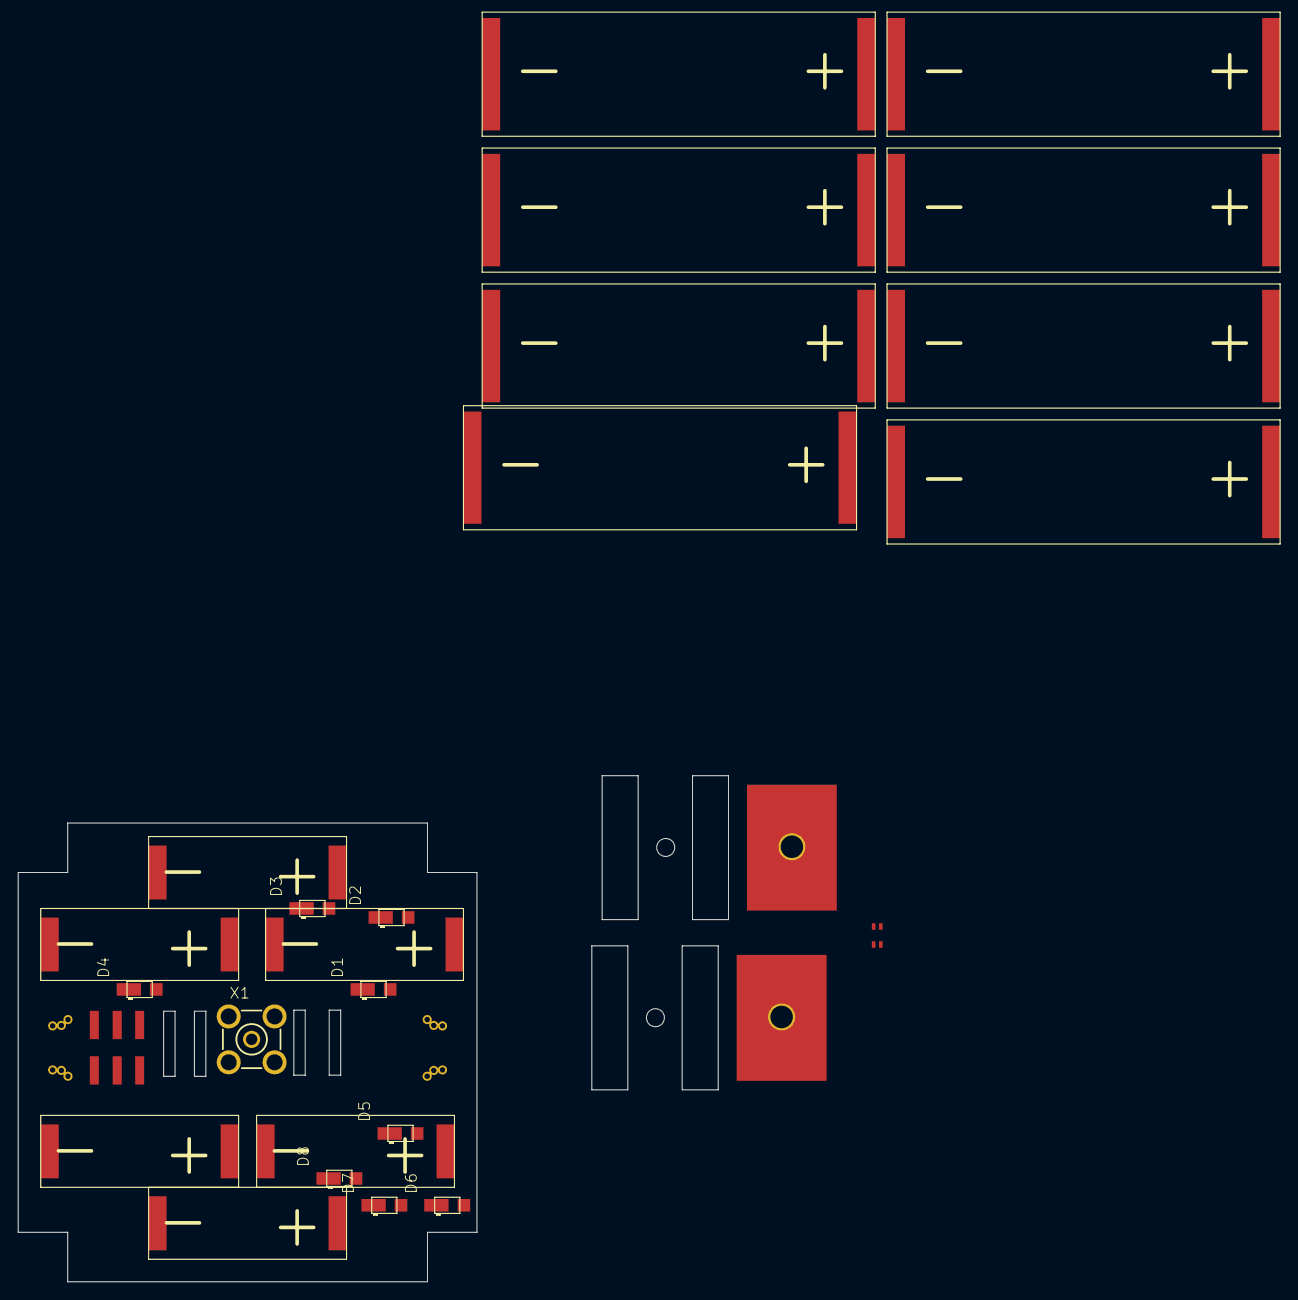
[picture p30: board SolarZ.kicad_pcb from above]

Board: 4 copper layers, 29 parts (0 on the bottom side), 13 nets.
