spacecraft-design-lab-2019/SolarActuators/EnergyHarvesterRev1/PDB.kicad_pcb

## KiCad design EnergyHarvesterRev1/PDB.kicad_pcb (2019-10-14)

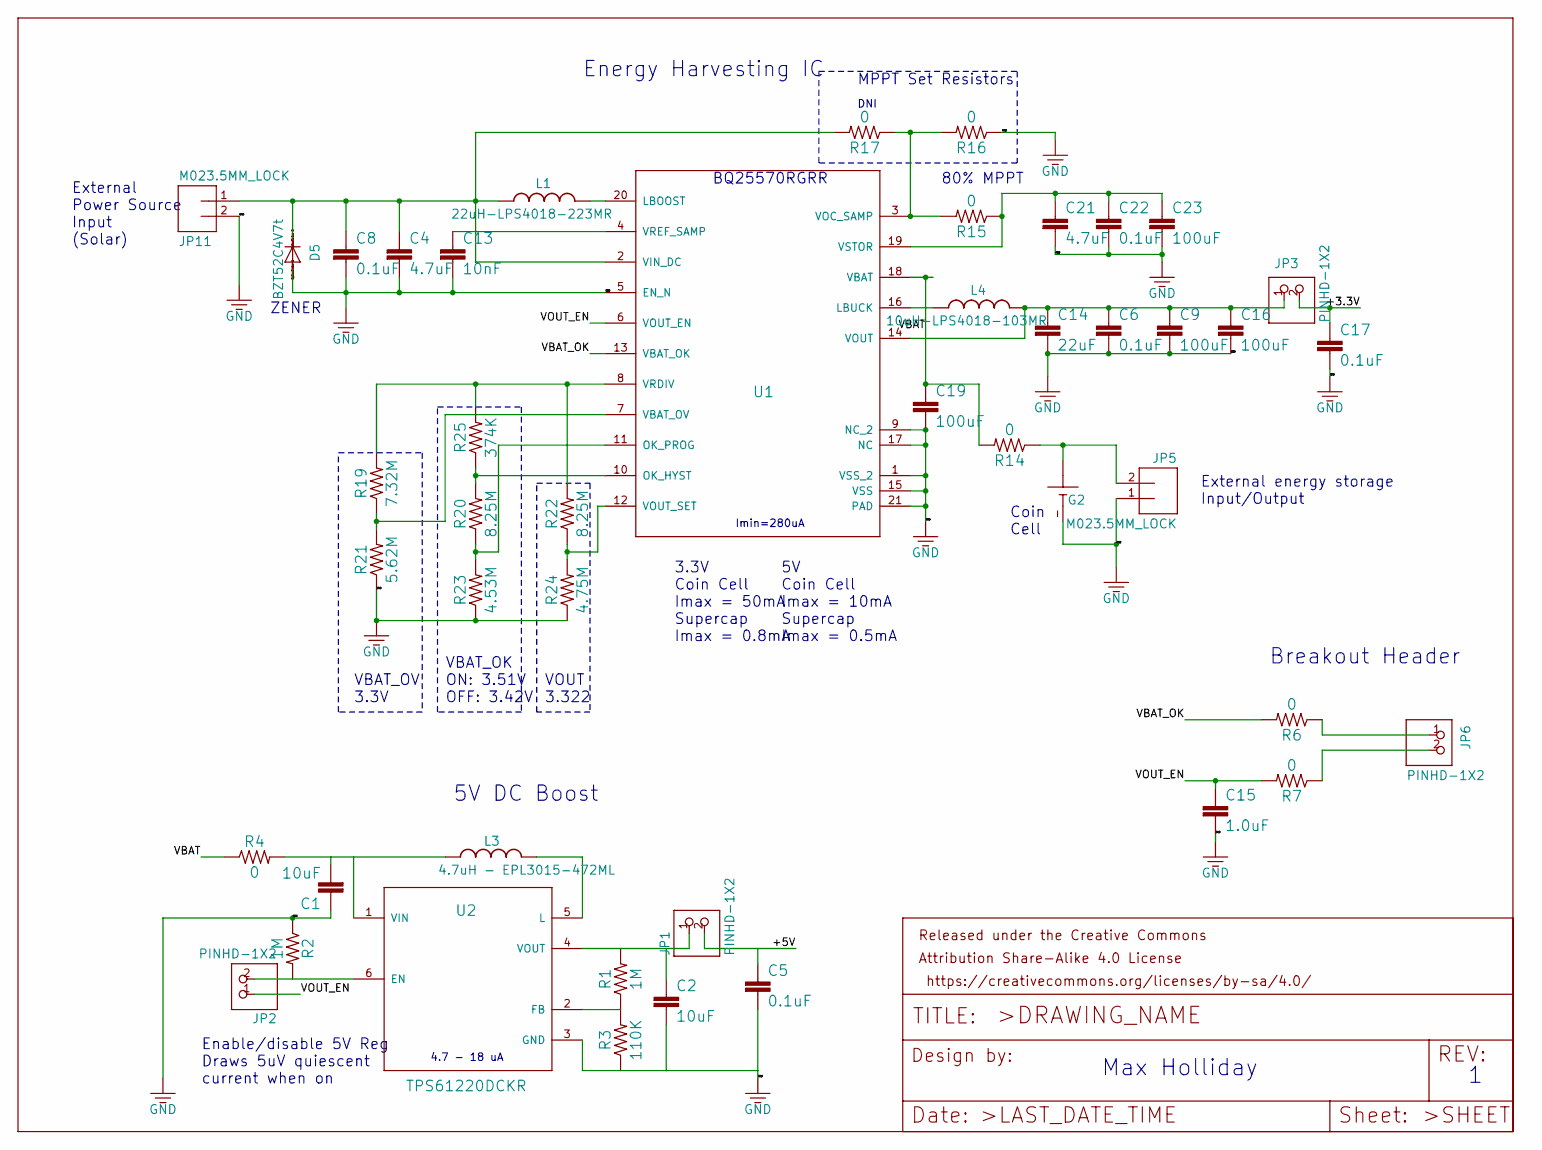
[picture p31: schematic PDB.sch]

Parts:
C1, C2: 10uF; 0603
C4, C21: 4.7uF; 0603
C5, C6, C8, C17, C22: 0.1uF; 0603
C9, C16, C19, C23: 100uF; 0603
C13: 10nF; 0603
C14: 22uF; 0805
C15: 1.0uF; 0603
D5: BZT52C4V7t; SOD523
FRAME1: FRAME-LETTERNO_PACKAGE; DUMMY
G2: 10MM_SM_COIN_CELL_CLIP
JP1, JP2, JP3, JP6: PINHD-1X2; 1X02
JP5, JP11: M023.5MM_LOCK; SCREWTERMINAL-3.5MM-2_LOCK
L1: 22uH-LPS4018-223MR; LPS4018
L3: 4.7uH - EPL3015-472ML; DFE322512C
L4: 10uH-LPS4018-103MR; LPS4018
R1, R2: 1M; 0603
R3: 110K; 0603
R4, R6, R7, R14, R15, R16, R17: 0; 0603
R19: 7.32M; 0603
R20, R22: 8.25M; 0603
R21: 5.62M; 0603
R23: 4.53M; 0603
R24: 4.75M; 0603
R25: 374K; 0603
U1: Value; RGR0020A
U2: TPS61220DCKR; DCK0006A

Connections:
3.3V: C1.1, C2.2, C4.2, C5.2, C6.2, C8.2, C9.2, C13.2, C14.2, C15.2, C16.2, C17.2, C19.2, C21.2, C22.2, C23.2, D5.A, G2.-, JP5.1, JP11.2, R2.1, R3.1, R16.1, R21.1, R23.1, R24.1, U1.1 (VSS_2), U1.5 (EN_N), U1.9 (NC_2), U1.15 (VSS), U1.17 (NC), U1.21 (PAD), U2.3 (GND)
/+3.3V: C17.1, JP3.2
/+5V: C5.1, JP1.2
/VBAT: C19.1, R4.1, R14.2, U1.18 (VBAT)
/VBAT_OK: R6.2, U1.13 (VBAT_OK)
/VOUT_EN: C15.1, JP2.1, R7.2, U1.6 (VOUT_EN)
unnamed: C1.2, L3.P$1 (1), R4.2, U2.1 (VIN)
unnamed: C2.1, JP1.1, R1.2, U2.4 (VOUT)
unnamed: C4.1, C8.1, D5.C, JP11.1, L1.1, R17.2, U1.2 (VIN_DC)
unnamed: C13.1, U1.4 (VREF_SAMP)
unnamed: C6.1, C9.1, C14.1, C16.1, JP3.1, L4.2, U1.14 (VOUT)
unnamed: C21.1, C22.1, C23.1, R15.1, U1.19 (VSTOR)
unnamed: G2.+@1 (+), G2.+@2 (+), JP5.2, R14.1
unnamed: JP2.2, R2.2, U2.6 (EN)
unnamed: JP6.1, R6.1
unnamed: JP6.2, R7.1
unnamed: L1.2, U1.20 (LBOOST)
unnamed: L3.P$2 (2), U2.5 (L)
unnamed: L4.1, U1.16 (LBUCK)
unnamed: R1.1, R3.2, U2.2 (FB)
unnamed: R15.2, R16.2, R17.1, U1.3 (VOC_SAMP)
unnamed: R19.1, R21.2, U1.7 (VBAT_OV)
unnamed: R19.2, R22.2, R25.2, U1.8 (VRDIV)
unnamed: R20.1, R23.2, U1.11 (OK_PROG)
unnamed: R20.2, R25.1, U1.10 (OK_HYST)
unnamed: R22.1, R24.2, U1.12 (VOUT_SET)

Notes on the sheet:
DNI
ZENER
VOUT 3.322
80% MPPT
VBAT_OK ON: 3.51V OFF: 3.42V
VBAT_OV 3.3V
Enable/disable 5V Reg Draws 5uV quiescent current when on
3.3V Coin Cell Imax = 50mA Supercap Imax = 0.8mA
5V Coin Cell Imax = 10mA Supercap Imax = 0.5mA
4.7 - 18 uA
Imin=280uA
Coin Cell
External Power Source Input (Solar)
MPPT Set Resistors
External energy storage Input/Output
BQ25570RGRR
Max Holliday
5V DC Boost
Energy Harvesting IC
Breakout Header

Board: 2 copper layers, 47 parts (0 on the bottom side), 26 nets, no tracks yet.
