spacecraft-design-lab-2019/SolarActuators/SolarZ/SolarZ/SolarZ.brd

## EAGLE design SolarZ/SolarZ/SolarZ.brd (2019-10-21)

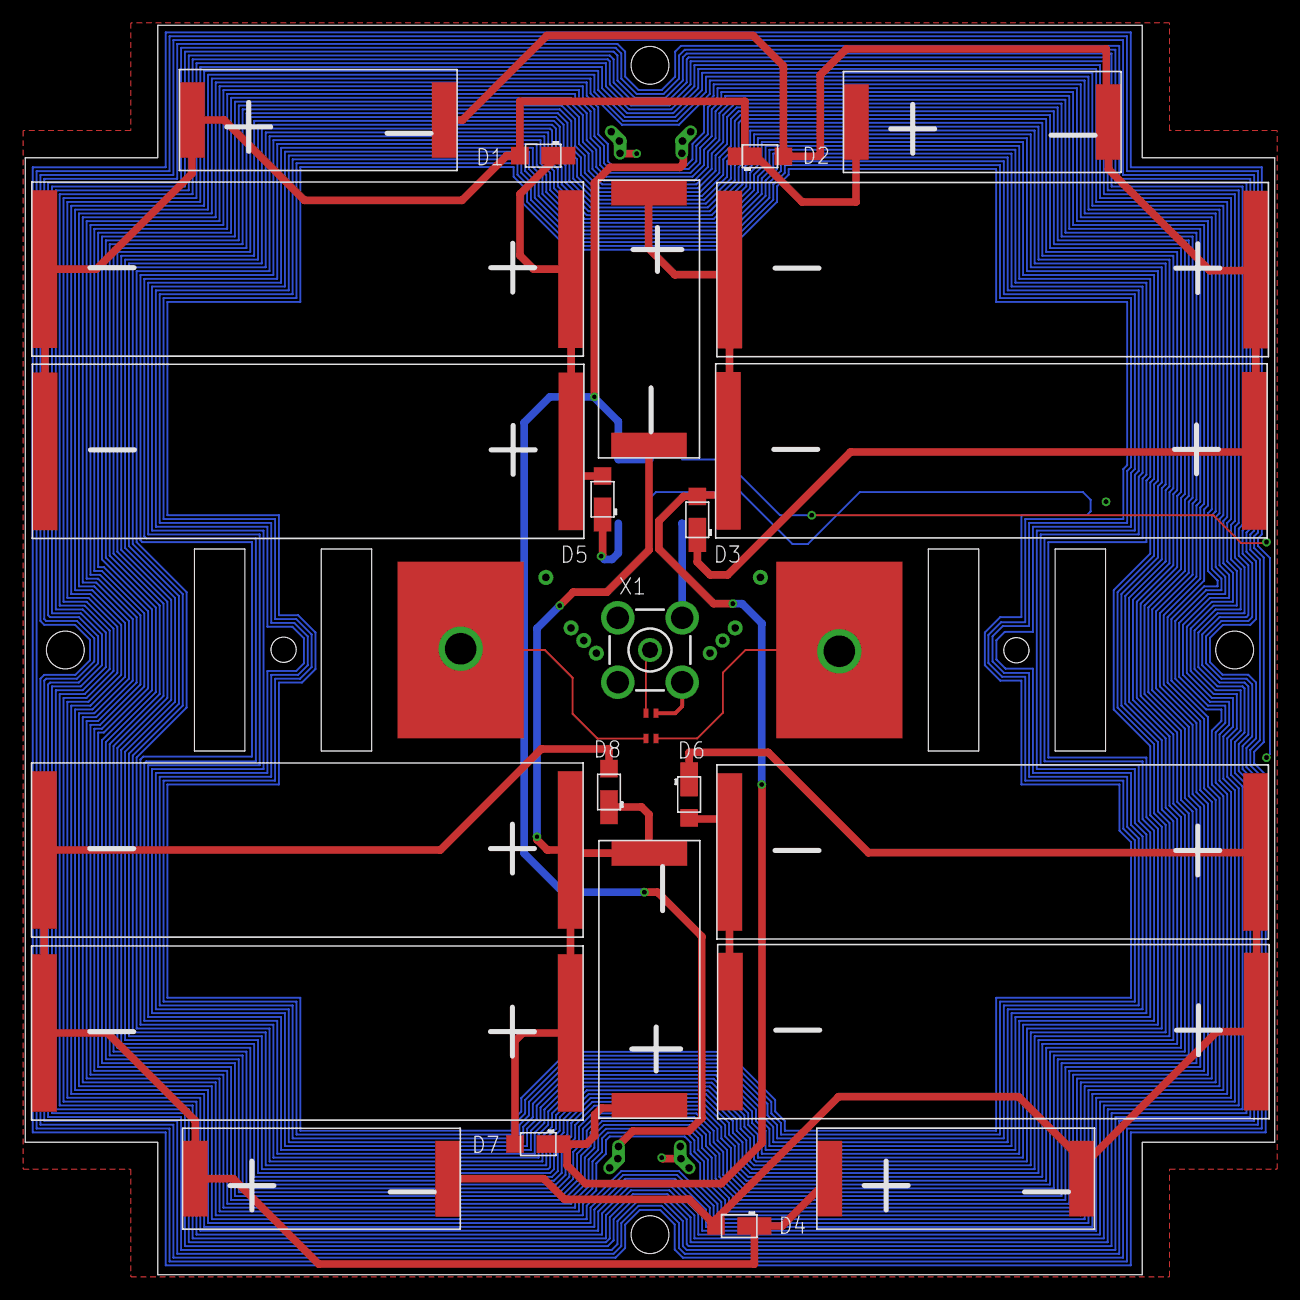
[picture p32: board SolarZ.brd from above]

Board: 4 copper layers, 99.0 x 99.0 mm, 29 parts (1 on the bottom side), 14 nets.

Parts:
1, 6, 7, 10, 11, 13: KXOB22-04X3F
2, 3, 4, 5, 8, 9, 12, 14: SLMD121H04L
D1, D2, D3, D4, D5, D6, D7, D8: SB_DIODE
F1, F2: BURN_WIRE
U$1: BALUN
U$2, U$3: TAPE
U$4: M20-8760342
X1: BU-SMA-V

Connections:
GND: 8.P$1, 9.P$1, D6.POS, F1.2, F1.20, F1.200, F2.2, F2.20, F2.200, U$1.3, U$4.P$1, X1.2, X1.3, X1.4, X1.5
N8: 6.P$2, 7.P$2, 12.P$1, 14.P$1, D4.NEG, D8.POS
unnamed: U$1.2, U$3.RF, U$3.RF_2
unnamed: U$1.4, X1.1
unnamed: U$1.1, U$2.RF, U$2.RF_2
unnamed: 1.P$2, 2.P$1, 3.P$1, 13.P$2, D1.POS, D2.NEG
unnamed: 2.P$2, 3.P$2, D1.NEG, D5.POS
unnamed: U$4.P$2, U$4.P$3
unnamed: 10.P$1, 11.P$1, 12.P$2, 14.P$2, D7.POS, D8.NEG
unnamed: 1.P$1, 4.P$2, 5.P$2, 13.P$1, D2.POS, D3.NEG
unnamed: 6.P$1, 7.P$1, 8.P$2, 9.P$2, D4.POS, D6.NEG
unnamed: 4.P$1, 5.P$1, 10.P$2, 11.P$2, D3.POS, D7.NEG
unnamed: F1.1, F1.10, F1.100, F2.1, F2.10, F2.100, U$4.P$4, U$4.P$6
VSOLAR: D5.NEG, U$4.P$5
