spacecraft-design-lab-2019/SolarActuators/SolarZ/Solar Panel/SolarCellY/SolarCellY_v2_6milmag.brd

## EAGLE design SolarZ/Solar Panel/SolarCellY/SolarCellY_v2_6milmag.brd (2019-10-21)

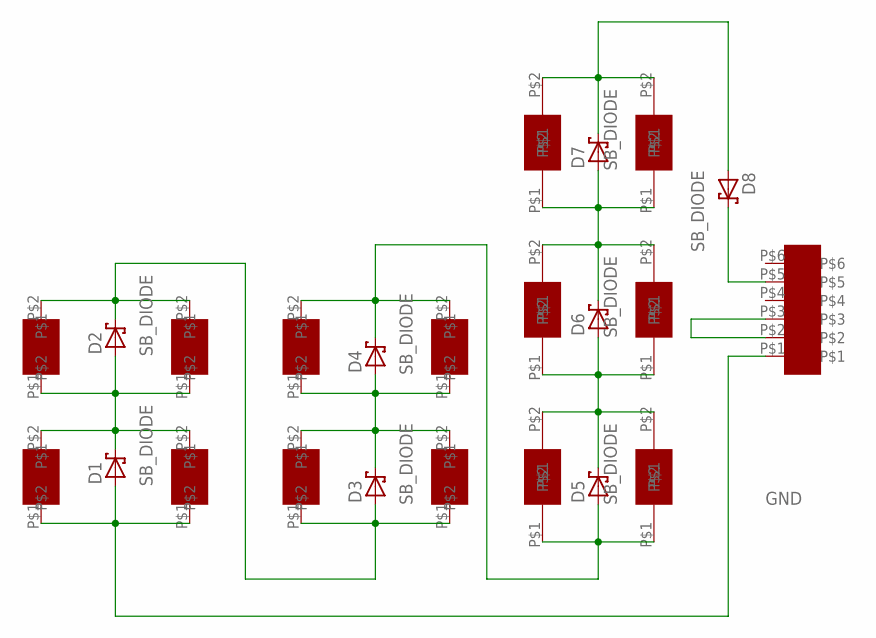
[picture p33: schematic SolarCellY_v2_6milmag.sch]

Parts:
11, 12, 13, 14, 21, 22, 23, 24: SLMD121H04L
D1, D2, D3, D4, D5, D6, D7, D8: SB_DIODE
U$1: M20-8760342
U$2, U$3, U$4, U$5, U$6, U$7: KXOB22-04X3F

Connections:
GND: 11.P$1, 12.P$1, D1.POS, U$1.P$1
unnamed: U$1.P$2, U$1.P$3
unnamed: 11.P$2, 12.P$2, 13.P$1, 14.P$1, D1.NEG, D2.POS
unnamed: 13.P$2, 14.P$2, 21.P$1, 22.P$1, D2.NEG, D3.POS
unnamed: 23.P$2, 24.P$2, D4.NEG, D5.POS, U$2.P$1, U$3.P$1
unnamed: 21.P$2, 22.P$2, 23.P$1, 24.P$1, D3.NEG, D4.POS
unnamed: D5.NEG, D6.POS, U$2.P$2, U$3.P$2, U$4.P$1, U$5.P$1
unnamed: D6.NEG, D7.POS, U$4.P$2, U$5.P$2, U$6.P$1, U$7.P$1
unnamed: D7.NEG, D8.POS, U$6.P$2, U$7.P$2
unnamed: D8.NEG, U$1.P$5

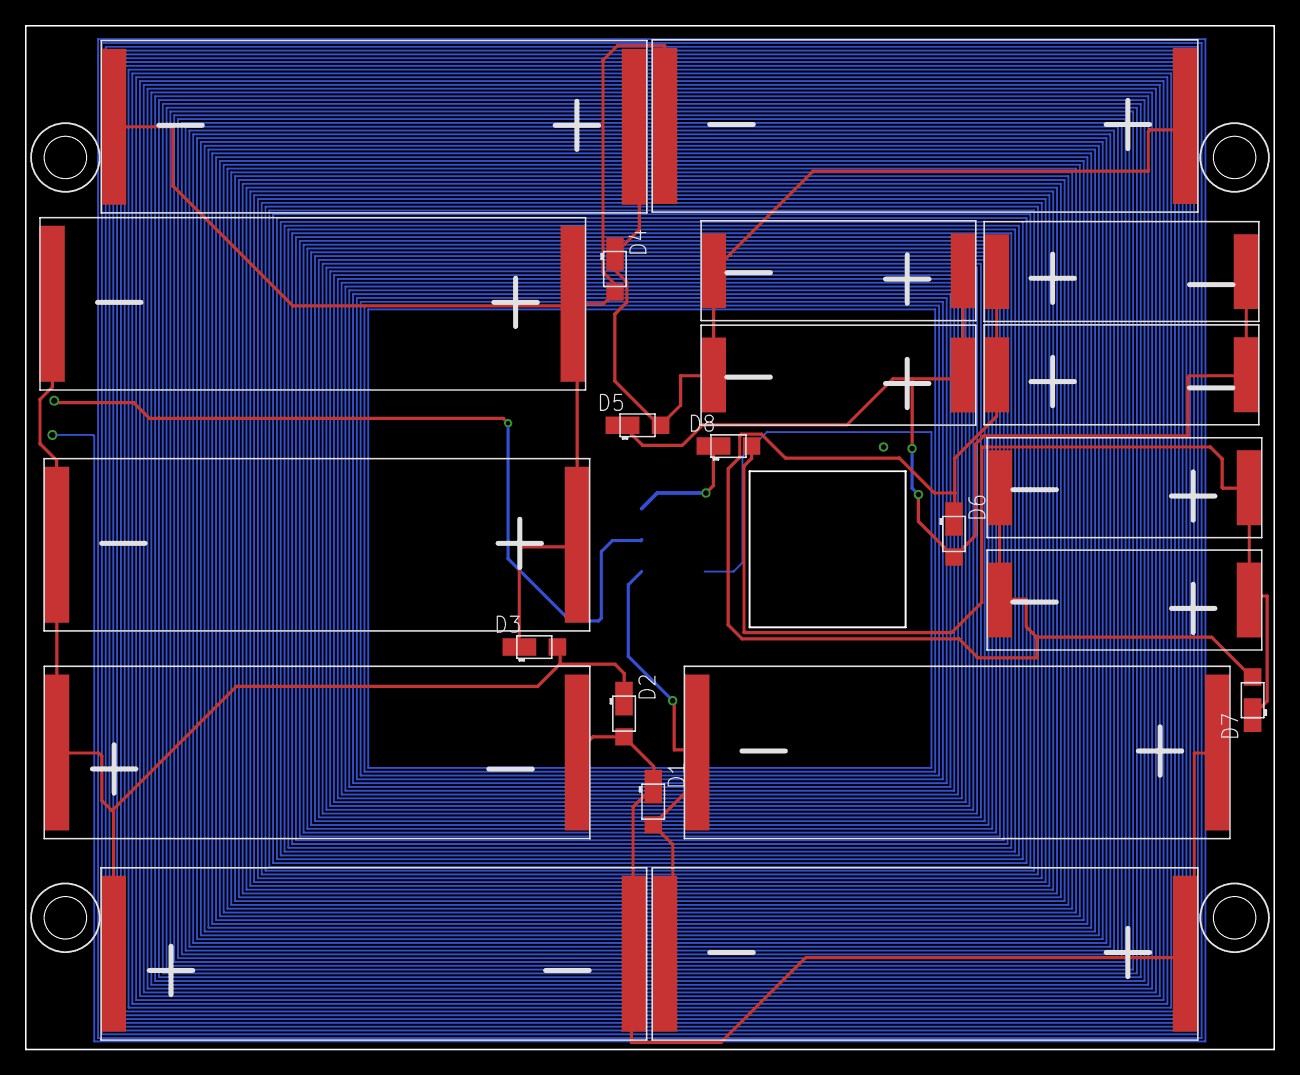
[picture p34: board SolarCellY_v2_6milmag.brd from above]

Board: 4 copper layers, 100.0 x 82.0 mm, 23 parts (1 on the bottom side), 10 nets.
