spacecraft-design-lab-2019/SolarActuators/(commit log)

2019-10-08 Create Charging circuit reference
2019-10-08 Added datasheet for charging IC
2019-10-09 Example solar cell & torquer designs from PandaSat
2019-10-10 Added power over orbit calculator
    [power_over_orbit_calc.xlsx]
2019-10-11 adding bq25570 example design and datasheet
    [EBH-10.brd, EBH-10.sch, EBH-10_BOM.csv, EHB-10_BOM_2018-04-10.csv, EHB-10_CART_2018-04-10 .xls]
2019-10-13 Added magnetorquer references
2019-10-14 Added blank files for the new PCB layout
    [PDB.kicad_pcb, PDB.sch]
2019-10-14 Added components + lib to board!
    [PDB.kicad_pcb]
2019-10-21 Set up directory for antenna/+Z board.
    [DRILEGEND.CFG, SolarCellX_v2_10milmag.brd, SolarCellX_v2_10milmag.sch, SolarCellX_v2_6milmag.brd, SolarCellX_v2_6milmag.sch, SolarCellY_v2_6milmag.brd, SolarCellY_v2_6milmag.sch, SolarZ.brd]
2019-10-21 Added sub-files, did early layout and cleanup.
    [DRILEGEND.CFG, SolarZ.brd]
2019-10-21 Preliminary layout, pending updates from AV about radio.
    [SolarZ.kicad_pcb]
2019-10-28 PCB test log file added
2019-10-30 Added energy circuit test notes
2019-10-31 Added updates power over orbit calculations
    [power_over_orbit_calc.xlsx]
2019-11-12 Update test report for diode lamp_light
2019-11-12 Created main.py for burn wire testing
    Save this to a trinket M0 and play with the duty_cycle variable to find the optimal duty cycle for safe burning
    [main.py]
2019-12-09 Reference document for energy harvest board testing is added.
2019-12-09 Voltage plot is added.
2019-12-09 Add Vin < Vout(i.e., EXT BAT) testing voltage plot
2019-12-12 Detailed energy harvest board testing report
